slapplebags/Tracksoar_Hardware/README.md

View this project on [CADLAB.io](https://cadlab.io/project/1187). 

# Tracksoar_Hardware
