slapplebags/Tracksoar_Hardware/test boards/Tracksoar v2 .pdf

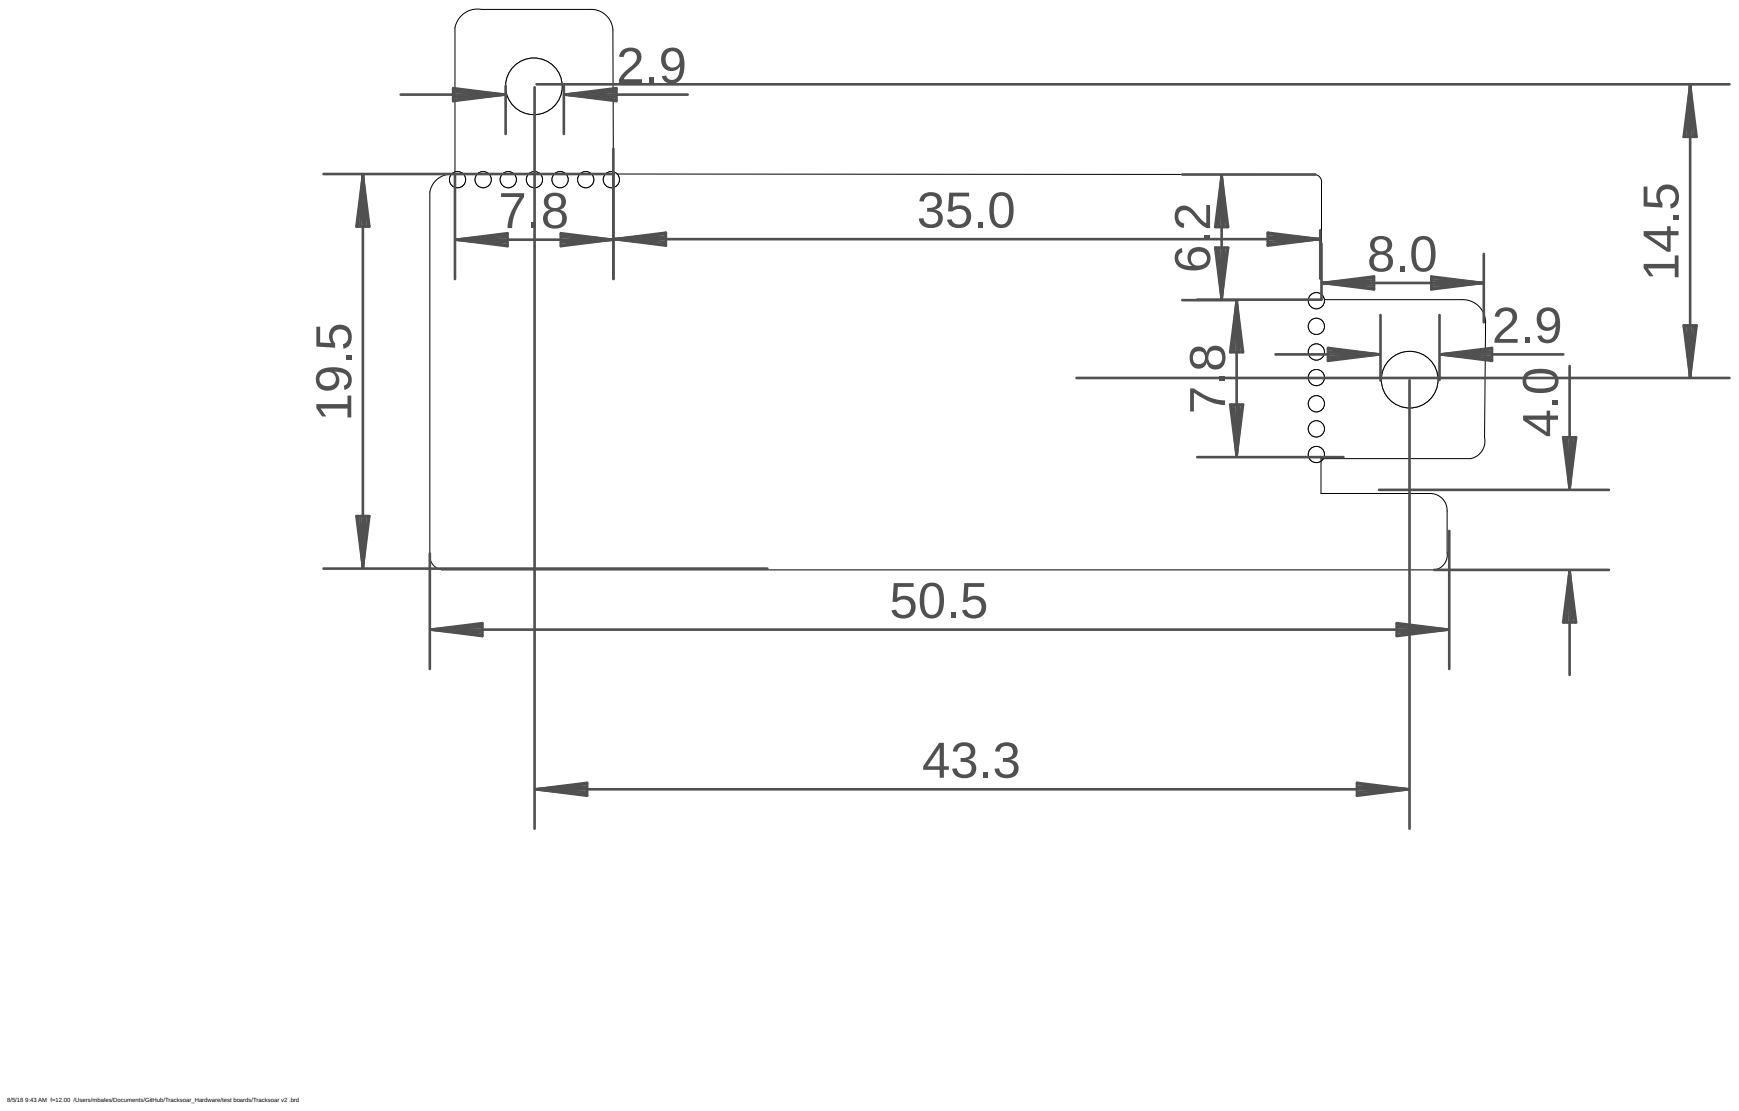
[picture p1: page 1]

8/5/18 9:43 AM f=12.00 /Users/mbales/Documents/GitHub/Tracksoar_Hardware/test boards/Tracksoar v2 .brd
