slapplebags/Tracksoar_Hardware/test boards/Tracksoar board bottom.pdf

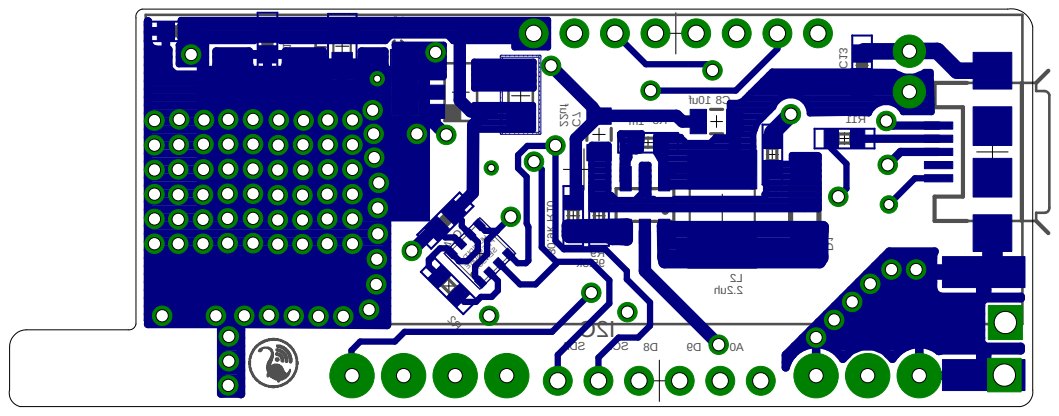
[picture p2: page 1]

C2I ADS L CS 8 D 9 D 0A 1 C f u1. D1 2L hu2. 2 m1 8 R 9 R k3. 59 R10 30.9k C7 22uff u01 8 C R2 11 R L1 C11 C13 C14 HUM DI TI Y PRESSURE SENSOR
