slapplebags/Tracksoar_Hardware/test boards/Tracksoar board power plane.pdf

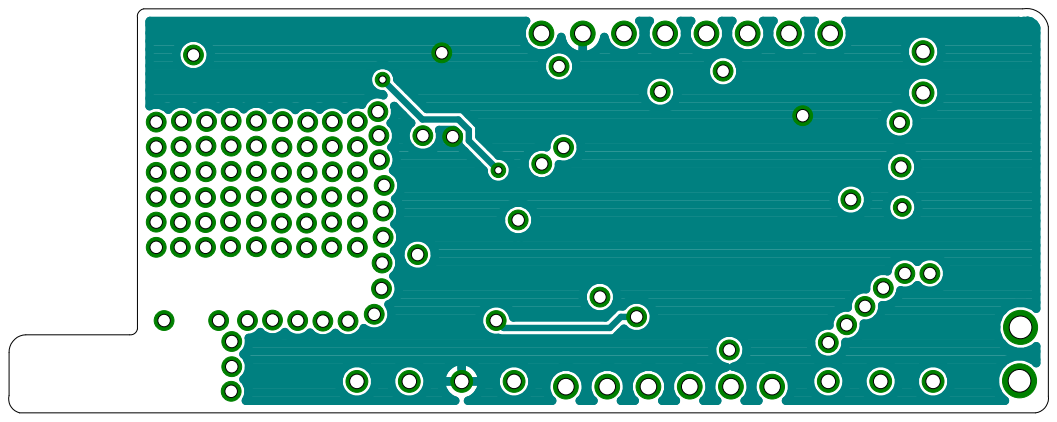
[picture p3: page 1]
