slapplebags/Tracksoar_Hardware/test boards/Tracksoar gndplane.pdf

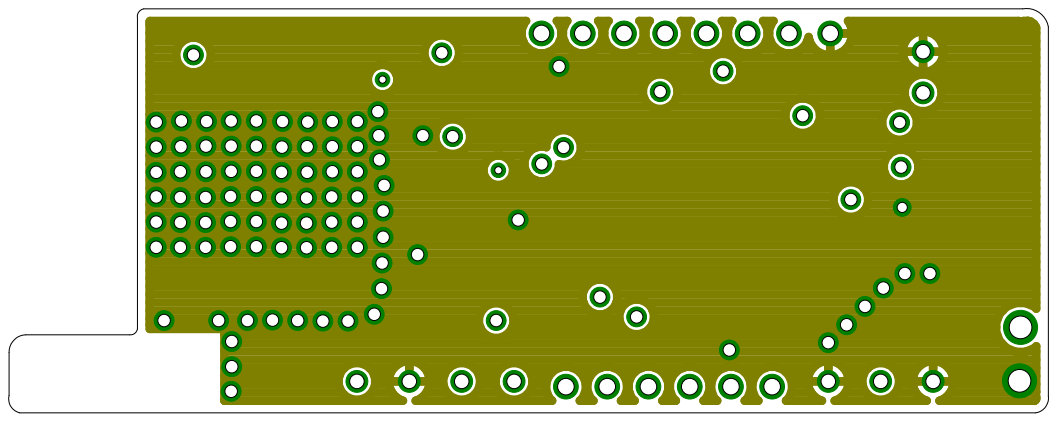
[picture p4: page 1]
