slapplebags/Tracksoar_Hardware/test boards/Tracksoar top board.pdf

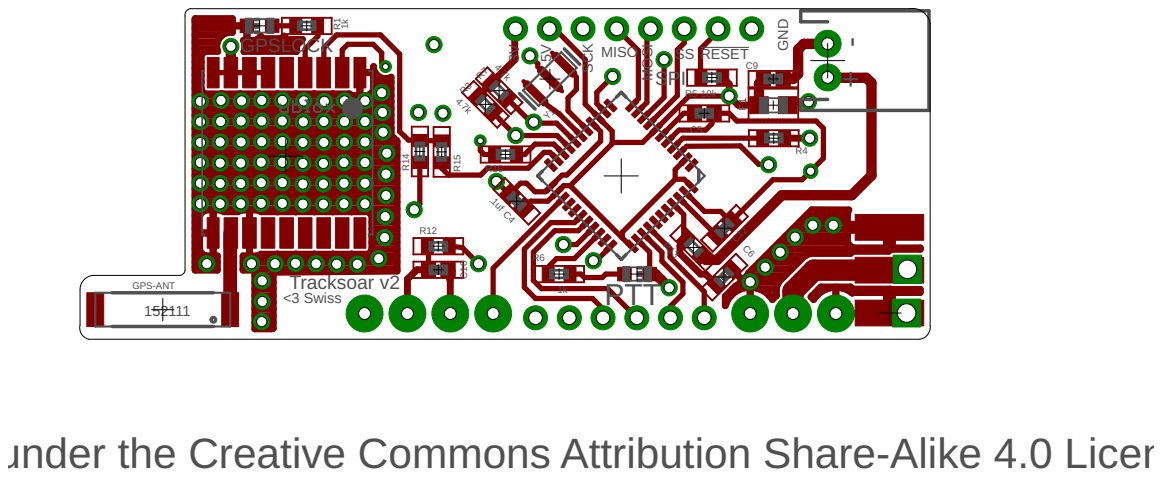
[picture p5: page 1]

Released under the Creative Commons Attribution Share-Alike 4.0 Licen
