slapplebags/Tracksoar_Hardware/test boards/Tracksoar v2 schematic.pdf

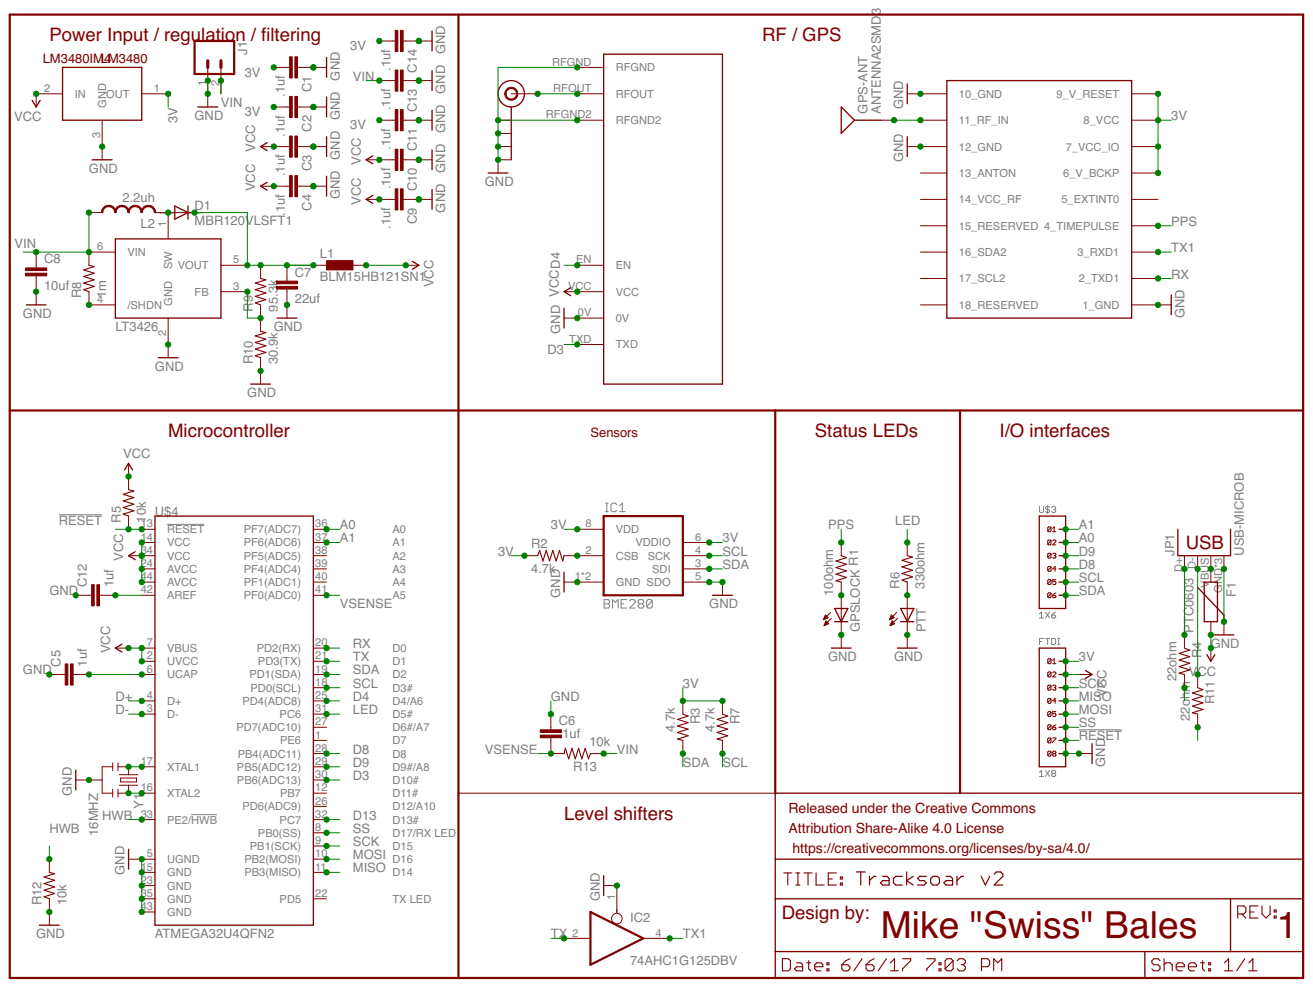
[picture p6: page 1]

Released under the Creative Commons Attribution Share-Alike 4.0 License

https://creativecommons.org/licenses/by-sa/4.0/
