slapplebags/Tracksoar_Hardware/test boards/Tracksoar v2 sd shield.brd

## EAGLE design test boards/Tracksoar v2 sd shield.brd (2019-05-08)

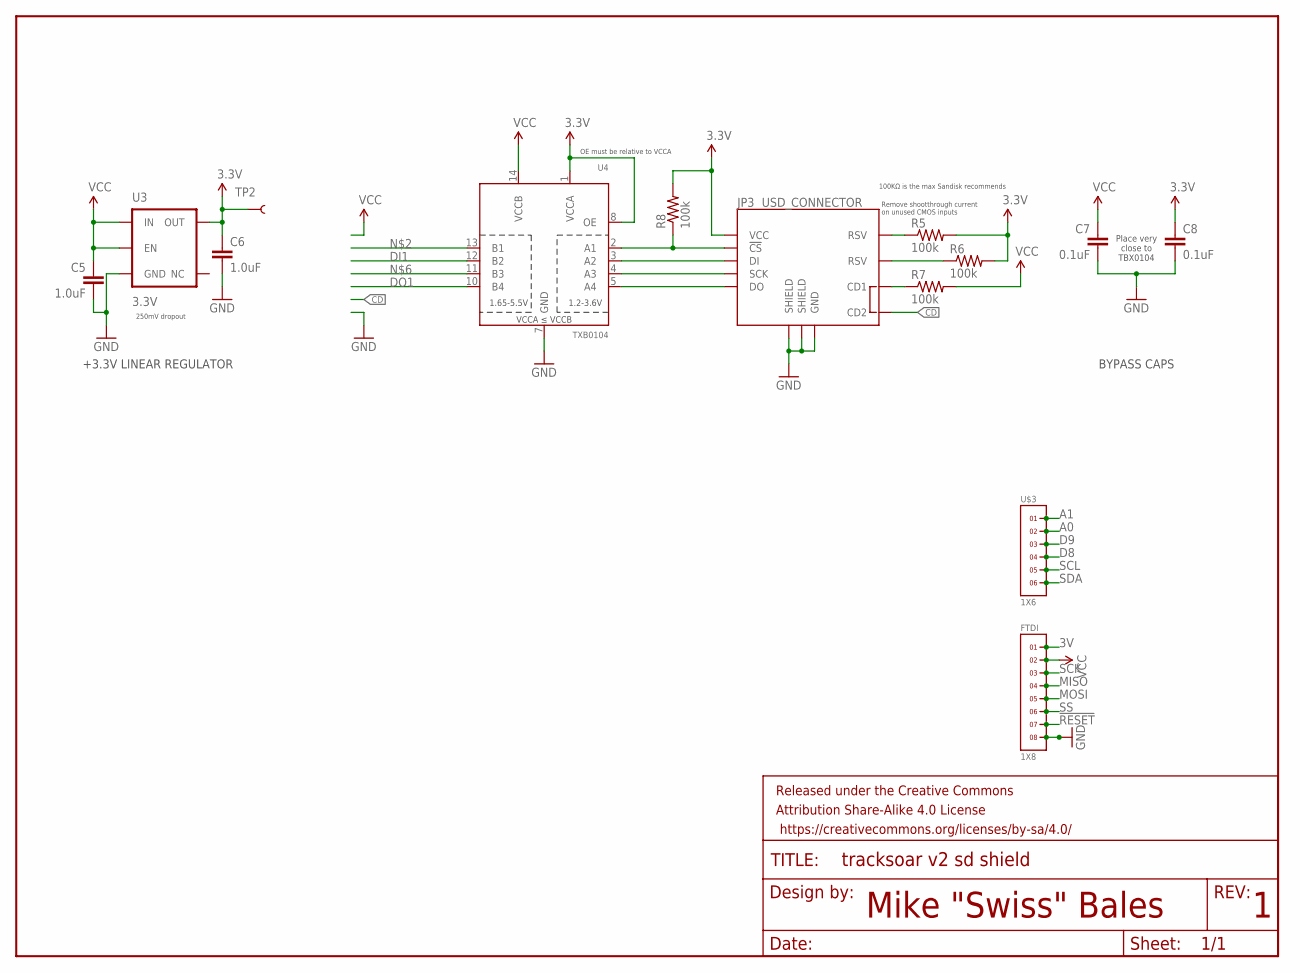
[picture p7: schematic Tracksoar v2 sd shield.sch]

Parts:
C5, C6: 1.0uF; 0603-CAP
C7, C8: 0.1uF; 0603-CAP
FRAME1: FRAME-LETTER; CREATIVE_COMMONS
FTDI: 1X8
JP3: USD_CONNECTOR; MICRO-SD-SOCKET-PP
R5, R6, R7, R8: 100k; 0603-RES
TP2: TEST-POINT3; PAD.03X.03
U3: 3.3V; SOT23-5
U4: TXB0104; SO14
U$3: 1X6

Connections:
3V: FTDI.1
3V3: C6.1, C8.1, JP3.VCC, R5.2, R6.2, R8.2, TP2.P$1, U3.5 (OUT), U4.1 (VCCA), U4.8 (OE)
!CS_3V1: JP3.CS (!CS), R8.1, U4.2 (A1)
!RESET: FTDI.7
A0: U$3.2
A1: U$3.1
CD: JP3.CD2
CDSDSD1: JP3.CD1, R7.1
D8: U$3.4
D9: U$3.3
DI1: U4.12 (B2)
DI_3V1: JP3.DI, U4.3 (A2)
DO1: U4.10 (B4)
DO_3V1: JP3.DO, U4.5 (A4)
GND: C5.2, C6.2, C7.2, C8.2, FTDI.8, JP3.GND, JP3.GND1 (SHIELD), JP3.GND3 (SHIELD), U3.2 (GND), U4.7 (GND)
MISO: FTDI.4
MOSI: FTDI.5
RSV@3: JP3.RSV1 (RSV), R5.1
RSV@4: JP3.RSV2 (RSV), R6.1
SCK: FTDI.3
SCK_3V1: JP3.SCLK (SCK), U4.4 (A3)
SCL: U$3.5
SDA: U$3.6
SS: FTDI.6
VCC: FTDI.2
VDD_IO: C5.1, C7.1, R7.2, U3.1 (IN), U3.3 (EN), U4.14 (VCCB)

Notes on the sheet:
Mike "Swiss" Bales
Remove shootthrough current on unused CMOS inputs
Place very close to TBX0104
OE must be relative to VCCA
+3.3V LINEAR REGULATOR
BYPASS CAPS
100KΩ is the max Sandisk recommends
250mV dropout

Board: 4 copper layers, 15 parts (13 on the bottom side), 10 nets, no tracks yet.
