slapplebags/Tracksoar_Hardware/test boards/Tracksoar v2 .brd

## EAGLE design test boards/Tracksoar v2 .brd (2019-05-08)

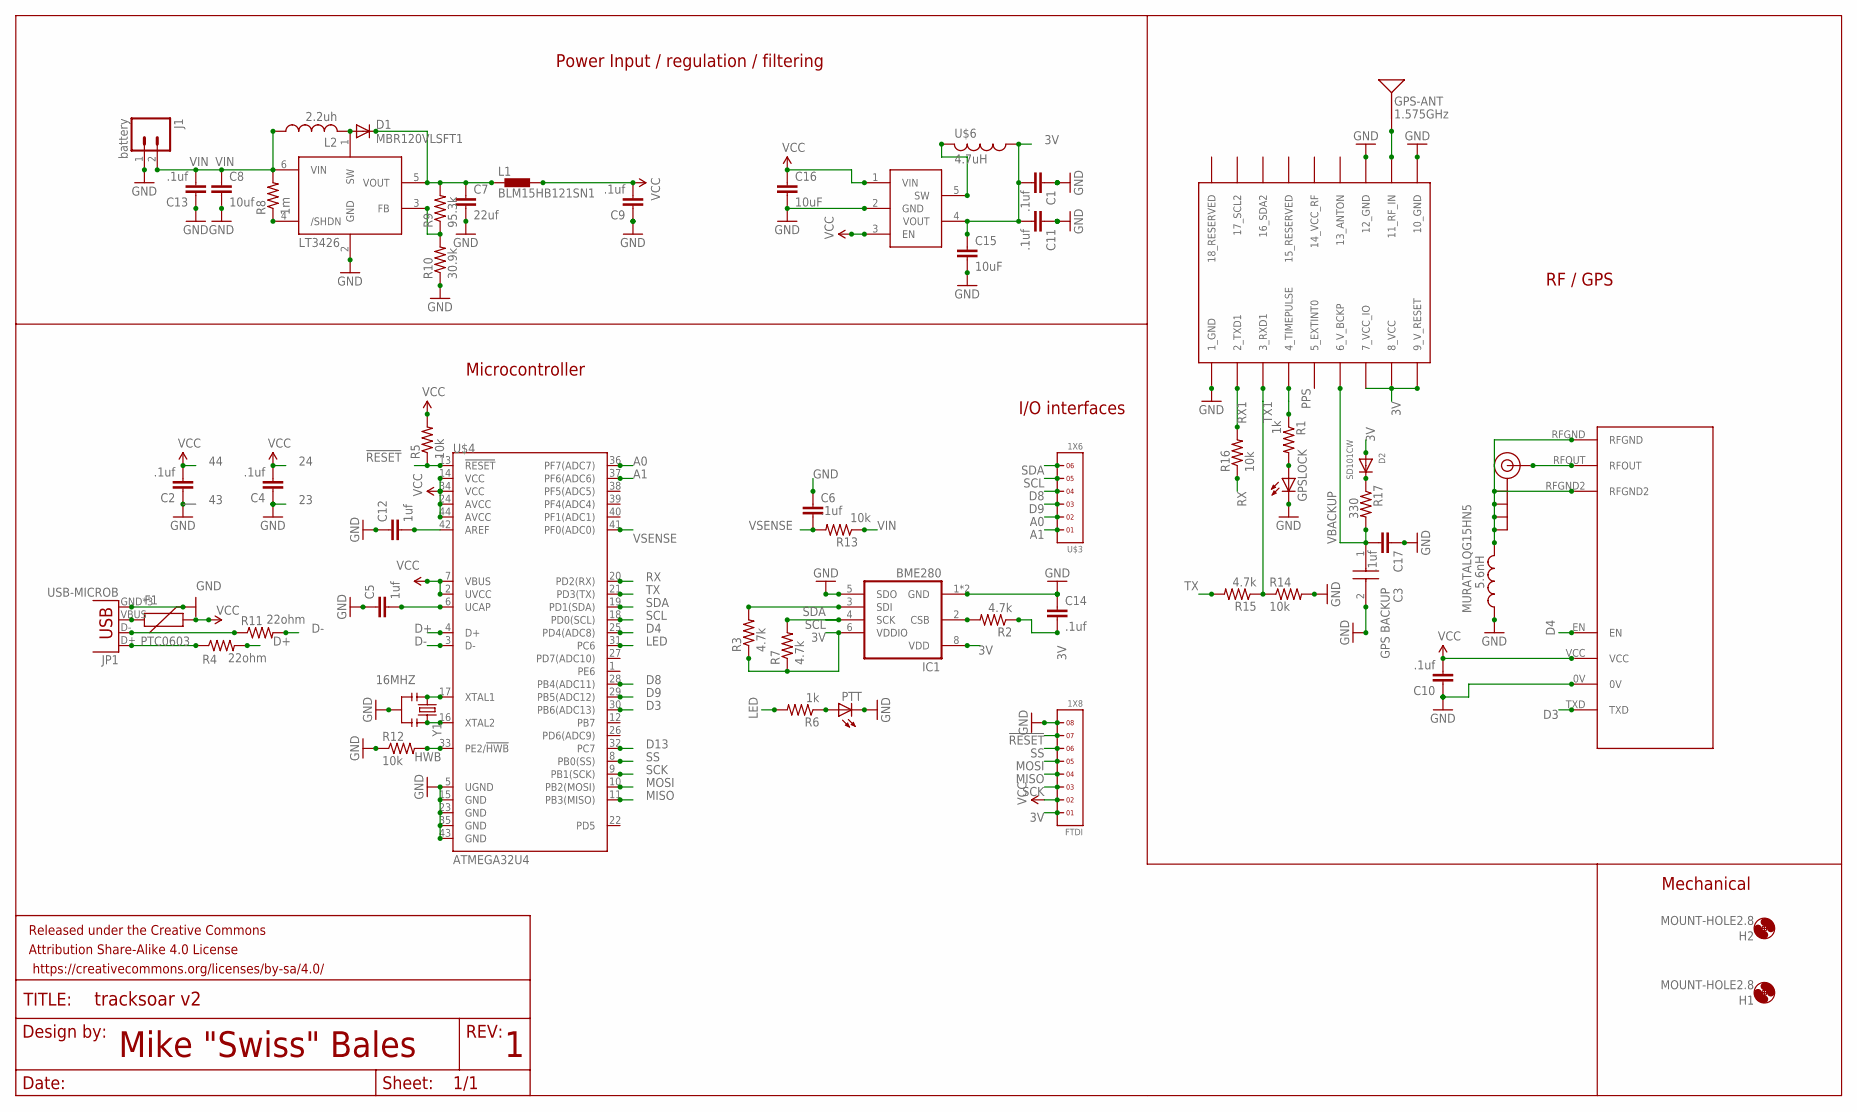
[picture p8: schematic Tracksoar v2 .sch]

Parts:
C1, C2, C4, C6, C9, C10, C11, C13, C14, C17: .1uf; 0402-CAP
C3: GPS BACKUP; DSK-3R3H204T614-H2L
C5, C12: 1uf; 0402-CAP
C7: 22uf; 0805
C8: 10uf; 0805
C15, C16: 10uF; 0603
D1: MBR120VLSFT1; SOD123
D2: SD101CW; SOD-123
F1: PTC0603; 0603
FRAME1: FRAME-LETTER; CREATIVE_COMMONS
FTDI: 1X8
GPS-ANT: 1.575GHz; ANT-GPS-2X7MM
GPSLOCK: LEDCHIP-LED0603; CHIP-LED0603
H1, H2: MOUNT-HOLE2.8; 2,8
IC1: BME280
J1: battery; JST-2-PTH
J$1: SMA_EDGE; SMA-EDGE
JP1: USB-MICROB
L1: BLM15HB121SN1; 0402
L2: 2.2uh; L1812
LT3426: LT3426; SOT23-6
MURATALQG15HN5: 5.6nH; RESC0402_N
PTT: LEDCHIP-LED0603; CHIP-LED0603
R1, R6: 1k; R0402
R2, R3, R7, R15: 4.7k; R0402
R4, R11: 22ohm; R0402
R5, R12, R13, R14, R16: 10k; R0402
R8: 1m; R0402
R9: 95.3k; R0402
R10: 30.9k; R0402
R17: 330; R0402
U$1: UBLOX_MAX
U$2: RADIOMETRIX-HX1
U$3: 1X6
U$4: ATMEGA32U4; QFN-44-NOPAD
U$5: PAM2305; DBV_R-PDSO-G5
U$6: 4.7uH; RESC0805_N
Y1: 16MHZ; RESONATOR-SMD

Connections:
3V: C1.2, C11.2, C14.2, C15.1, D2.A, FTDI.1, IC1.6 (VDDIO), IC1.8 (VDD), R2.1, R3.1, R7.1, U$1.7_VCC_IO, U$1.8_VCC, U$1.9_V_RESET, U$5.4 (VOUT), U$6.1
!RESET: FTDI.7, R5.1, U$4.13 (!RESET)
A0: U$3.2, U$4.36 (PF7(ADC7))
A1: U$3.1, U$4.37 (PF6(ADC6))
D3: U$2.TXD, U$4.30 (PB6(ADC13))
D4: U$2.EN, U$4.25 (PD4(ADC8))
D8: U$3.4, U$4.28 (PB4(ADC11))
D9: U$3.3, U$4.29 (PB5(ADC12))
D13: U$4.32 (PC7)
D+: R4.2, U$4.4 (D+)
D-: R11.2, U$4.3 (D-)
GND: C1.1, C2.1, C3.2 (-), C4.1, C5.1, C6.1, C7.2, C8.2, C9.1, C10.1, C11.1, C12.1, C13.1, C14.1, C15.2, C16.2, C17.1, FTDI.8, GPSLOCK.C, IC1.1 (GND), IC1.5 (SDO), IC1.7 (GND), J1.1, JP1.GND, JP1.MT1 (GND), JP1.MT2 (GND), LT3426.2 (GND), MURATALQG15HN5.1, PTT.C, R10.1, R12.1, R14.2, U$1.1_GND, U$1.10_GND, U$1.12_GND, U$2.0V, U$4.5 (UGND), U$4.15 (GND), U$4.23 (GND), U$4.35 (GND), U$4.43 (GND), U$5.2 (GND), Y1.2
HWB: R12.2, U$4.33 (PE2/!HWB)
LED: R6.2, U$4.31 (PC6)
MISO: FTDI.4, U$4.11 (PB3(MISO))
MOSI: FTDI.5, U$4.10 (PB2(MOSI))
unnamed: J$1.SIG (SIGNAL), U$2.RFOUT
unnamed: IC1.2 (CSB), R2.2
unnamed: GPSLOCK.A, R1.2
unnamed: GPS-ANT.1, U$1.11_RF_IN
unnamed: JP1.D-, R11.1
unnamed: JP1.D+, R4.1
unnamed: D1.A, L2.2, LT3426.1 (SW)
unnamed: LT3426.4 (/SHDN), R8.1
unnamed: LT3426.3 (FB), R9.1, R10.2
unnamed: F1.1, JP1.VBUS
unnamed: C12.2, U$4.42 (AREF)
unnamed: C7.1, D1.C, L1.1, LT3426.5 (VOUT), R9.2
unnamed: C5.2, U$4.6 (UCAP)
unnamed: U$5.5 (SW), U$6.2
unnamed: D2.C, R17.1
unnamed: PTT.A, R6.1
PPS: R1.1, U$1.4_TIMEPULSE
RFGND: J$1.GND@0 (GND), J$1.GND@1 (GND), J$1.GND@2 (GND), J$1.GND@3 (GND), MURATALQG15HN5.2, U$2.RFGND, U$2.RFGND2
RX: R16.1, U$4.20 (PD2(RX))
RX1: R16.2, U$1.2_TXD1
SCK: FTDI.3, U$4.9 (PB1(SCK))
SCL: IC1.4 (SCK), R7.2, U$3.5, U$4.18 (PD0(SCL))
SDA: IC1.3 (SDI), R3.2, U$3.6, U$4.19 (PD1(SDA))
SS: FTDI.6, U$4.8 (PB0(SS))
TX: R15.2, U$4.21 (PD3(TX))
TX1: R14.1, R15.1, U$1.3_RXD1
VBACKUP: C3.1 (+), C17.2, R17.2, U$1.6_V_BCKP
VCC: C2.2, C4.2, C9.2, C10.2, C16.1, F1.2, FTDI.2, L1.2, R5.2, U$2.VCC, U$4.2 (UVCC), U$4.7 (VBUS), U$4.14 (VCC), U$4.24 (AVCC), U$4.34 (VCC), U$4.44 (AVCC), U$5.1 (VIN), U$5.3 (EN)
VIN: C8.1, C13.2, J1.2, L2.1, LT3426.6 (VIN), R8.2, R13.1
VSENSE: C6.2, R13.2, U$4.41 (PF0(ADC0))
XTAL1: U$4.17 (XTAL1), Y1.1
XTAL2: U$4.16 (XTAL2), Y1.3

Notes on the sheet:
Mike "Swiss" Bales
Power Input / regulation / filtering
RF / GPS
Microcontroller
I/O interfaces
Mechanical

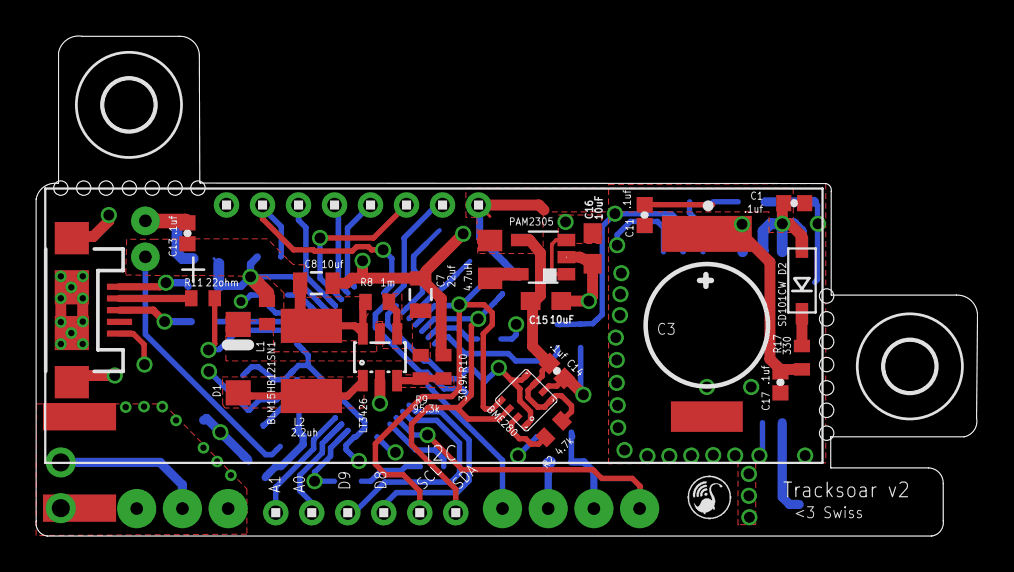
[picture p9: board Tracksoar v2 .brd from above]

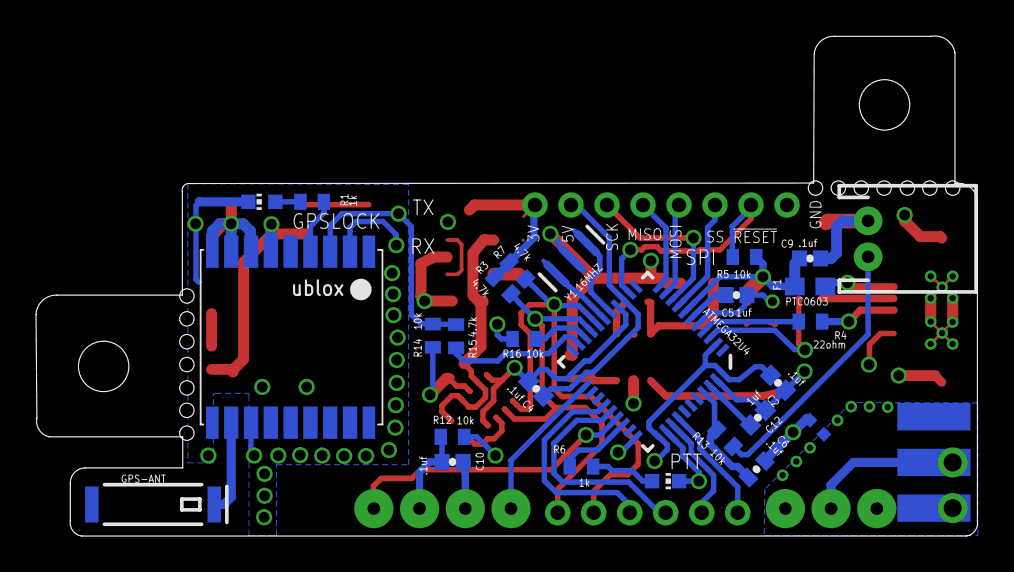
[picture p10: board Tracksoar v2 .brd from below]

Board: 4 copper layers, 52.3 x 27.8 mm, 59 parts (28 on the bottom side), 47 nets.
