slapplebags/Tracksoar_Hardware/test boards/Tracksoar v2 flash shield test.brd

## EAGLE design test boards/Tracksoar v2 flash shield test.brd (2018-07-14)

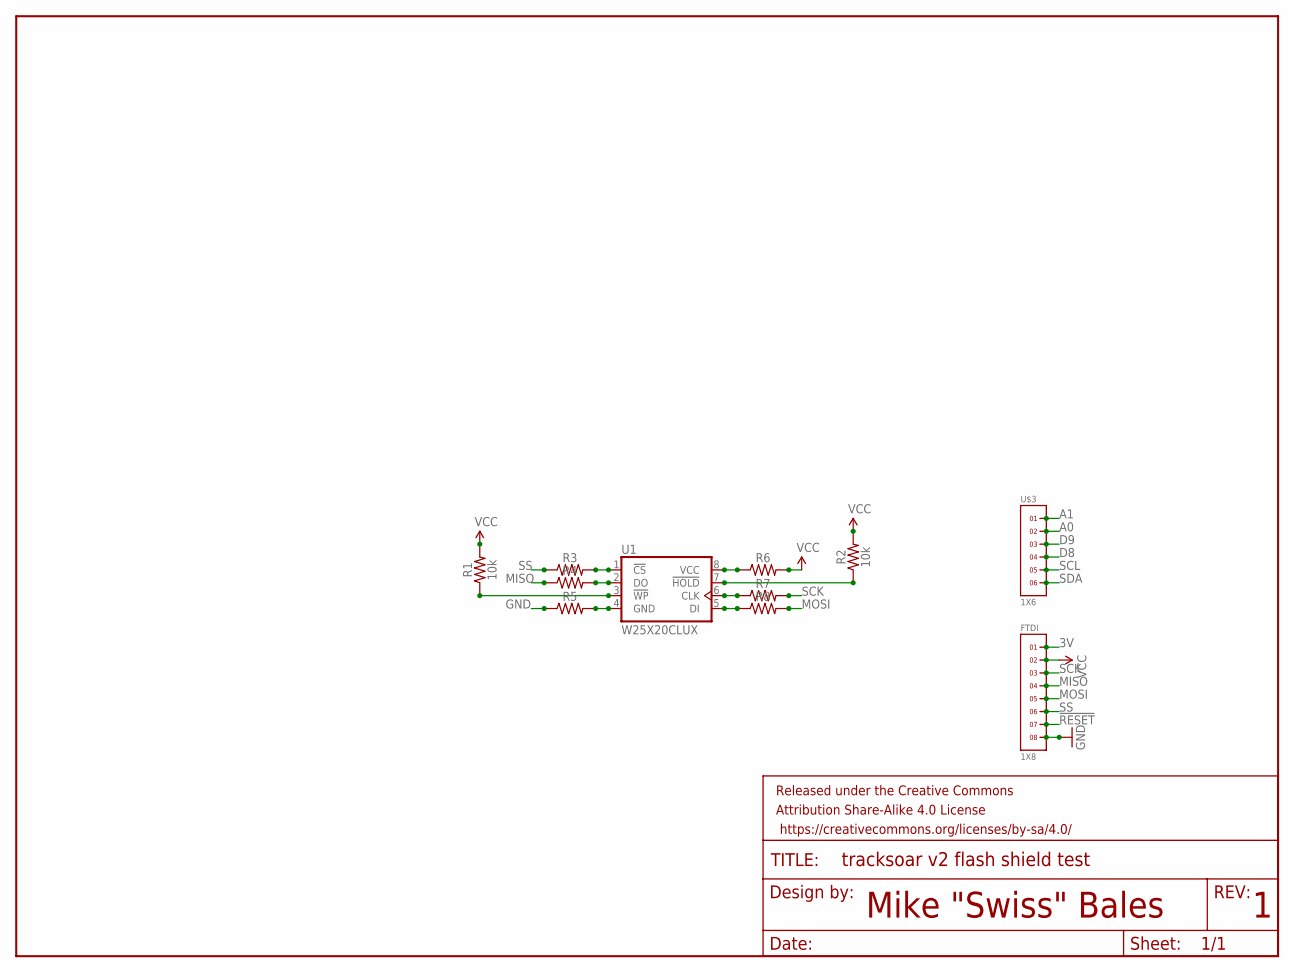
[picture p11: schematic Tracksoar v2 flash shield test.sch]

Parts:
FRAME1: FRAME-LETTER; CREATIVE_COMMONS
FTDI: 1X8
R1, R2: 10k; 0603
R3, R4, R5, R6, R7, R8: 0603
U1: W25X20CLUX; SON-8-50P-300W-200L-100H-40F-20EW-165EL
U$3: 1X6

Connections:
3V: FTDI.1
!RESET: FTDI.7
A0: U$3.2
A1: U$3.1
D8: U$3.4
D9: U$3.3
GND: FTDI.8, R5.1
MISO: FTDI.4, R4.1
MOSI: FTDI.5, R8.2
unnamed: R1.1, U1.3 (!WP!)
unnamed: R2.1, U1.7 (!HOLD!)
unnamed: R3.2, U1.1 (!CS!)
unnamed: R4.2, U1.2 (DO)
unnamed: R5.2, U1.4 (GND)
unnamed: R6.1, U1.8 (VCC)
unnamed: R7.1, U1.6 (CLK)
unnamed: R8.1, U1.5 (DI)
SCK: FTDI.3, R7.2
SCL: U$3.5
SDA: U$3.6
SS: FTDI.6, R3.1
VCC: FTDI.2, R1.2, R2.2, R6.2

Notes on the sheet:
Mike "Swiss" Bales

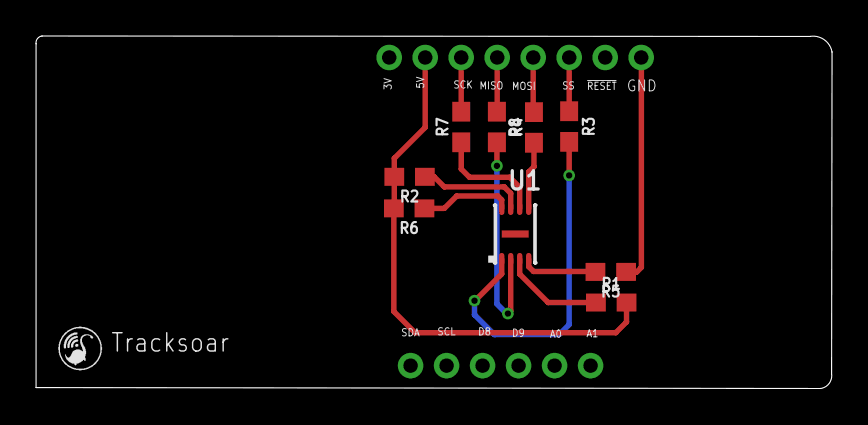
[picture p12: board Tracksoar v2 flash shield test.brd from above]

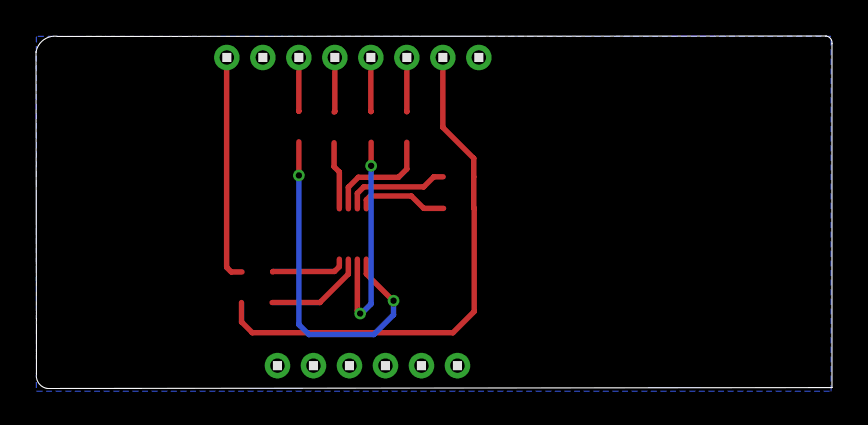
[picture p13: board Tracksoar v2 flash shield test.brd from below]

Board: 4 copper layers, 44.2 x 19.6 mm, 12 parts (2 on the bottom side), 14 nets.
