slapplebags/Tracksoar_Hardware/test boards/cutdown.brd

## EAGLE design test boards/cutdown.brd (2018-07-14)

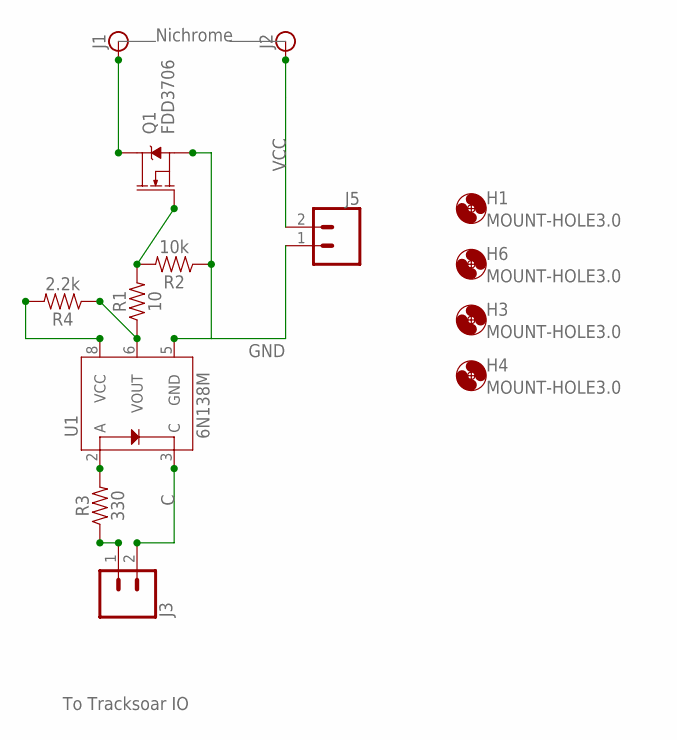
[picture p14: schematic cutdown.sch]

Parts:
H1, H3, H4, H6: MOUNT-HOLE3.0; 3,0
J1, J2: BANANA_CONN
J3, J5: CONN_02PTH3; 1X02_LONGPADS
Q1: FDD3706; DPAK
R1: 10; 0603
R2: 10k; 0603
R3: 330; 0603
R4: 2.2k; 0603
U1: 6N138M; 8-SMD

Connections:
A: J3.1, R3.1
C: J3.2, U1.3 (C)
GND: J5.1, Q1.3 (S), R2.1, U1.5 (GND)
unnamed: J1.P$1, Q1.4 (D)
unnamed: Q1.1 (G), R1.2, R2.2
unnamed: R1.1, R4.1, U1.6 (VOUT)
unnamed: R3.2, U1.2 (A)
unnamed: R4.2, U1.8 (VCC)
VCC: J2.P$1, J5.2

Notes on the sheet:
Nichrome
To Tracksoar IO

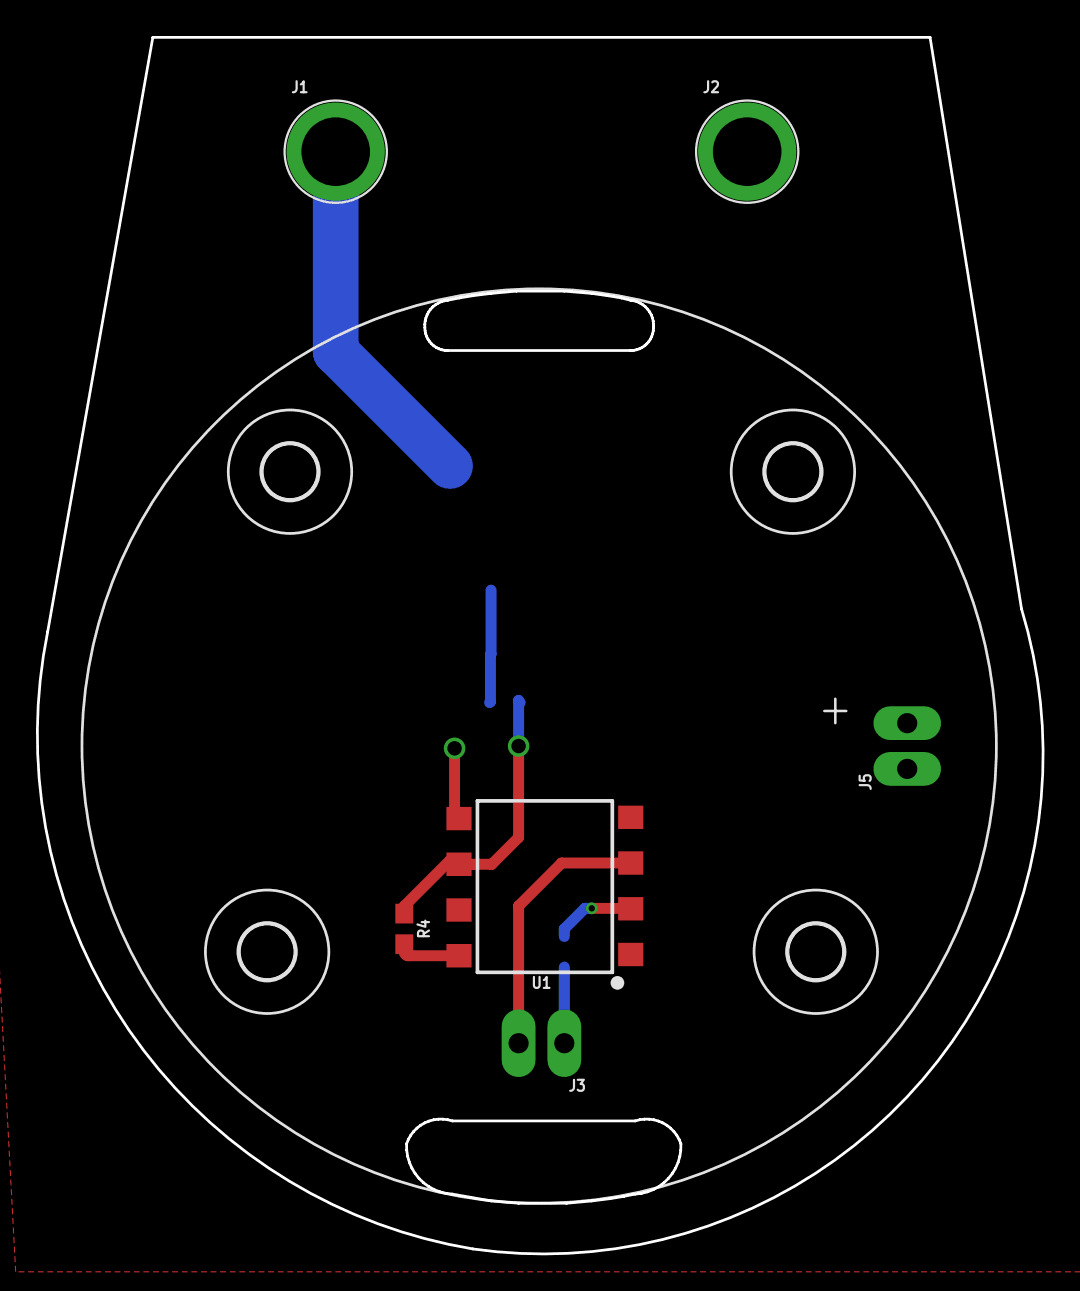
[picture p15: board cutdown.brd from above]

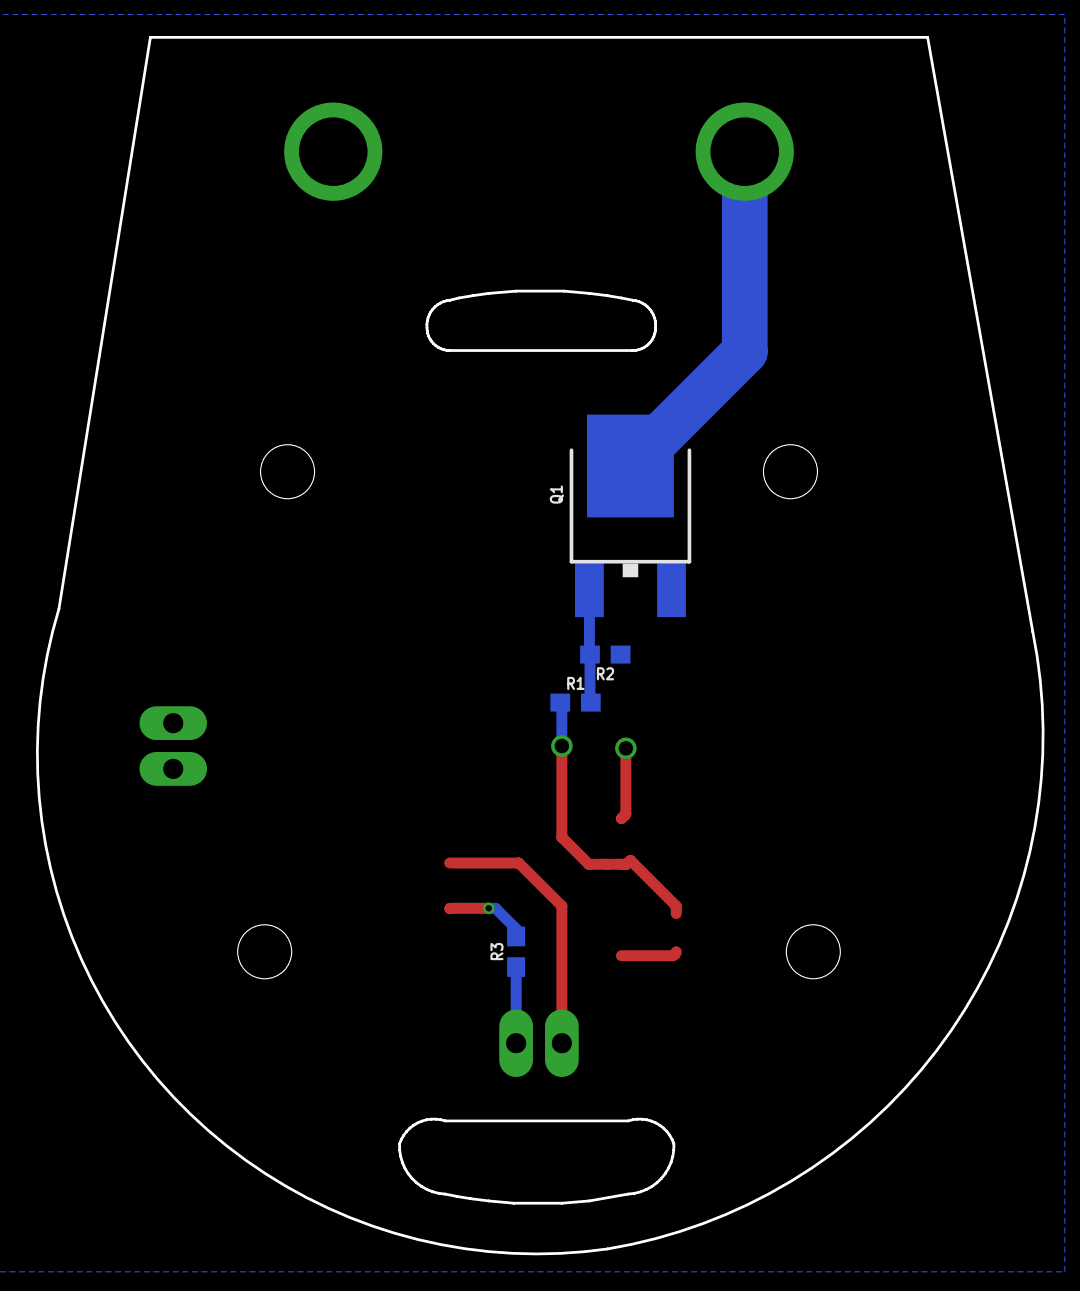
[picture p16: board cutdown.brd from below]

Board: 2 copper layers, 55.9 x 67.6 mm, 14 parts (4 on the bottom side), 9 nets.
