slapplebags/Tracksoar_Hardware/test boards/Tracksoar v2 breakout.brd

## EAGLE design test boards/Tracksoar v2 breakout.brd (2018-05-06)

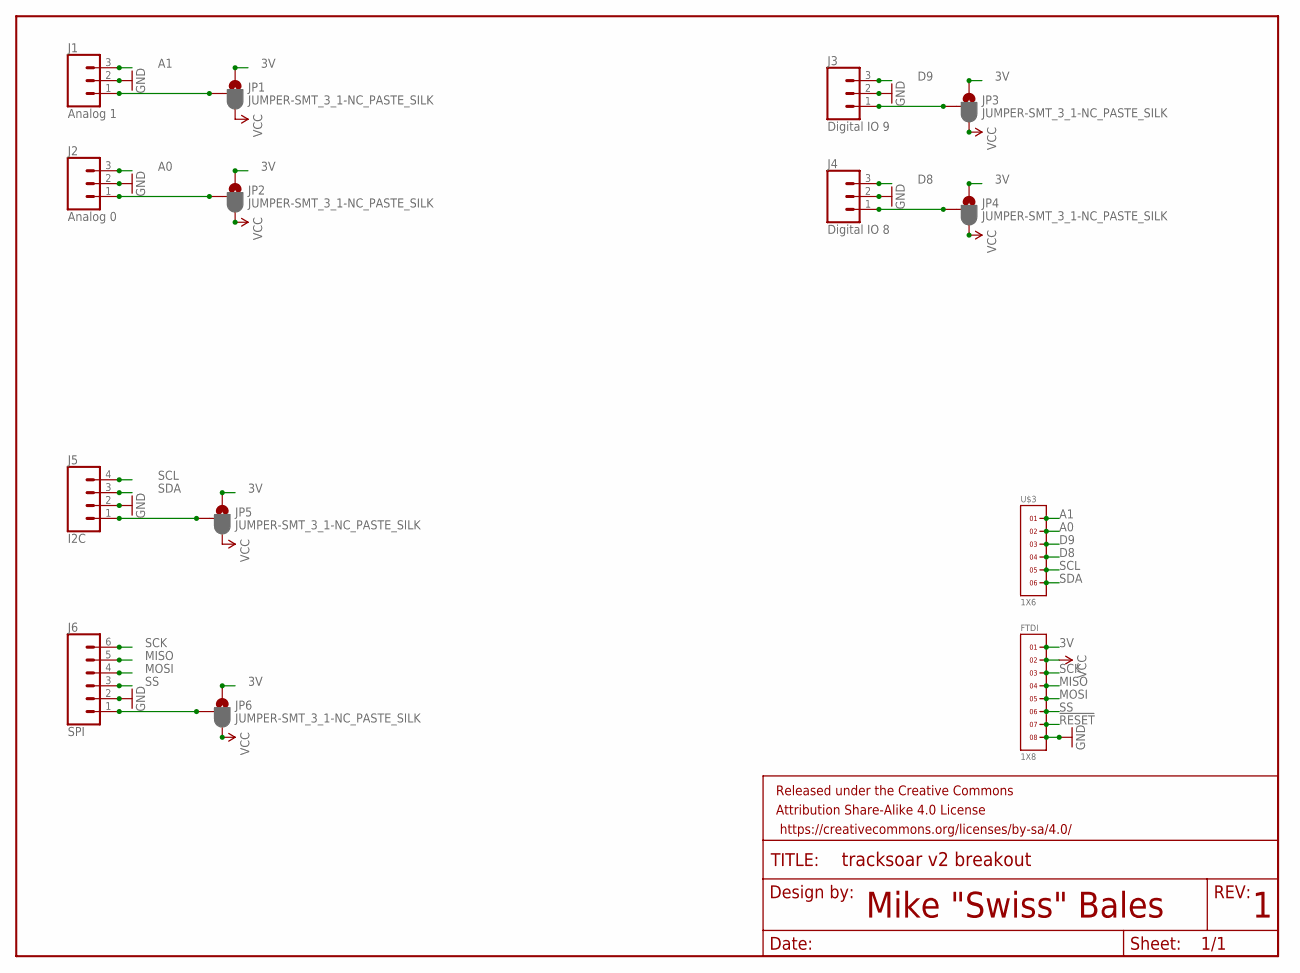
[picture p17: schematic Tracksoar v2 breakout.sch]

Parts:
FRAME1: FRAME-LETTER; CREATIVE_COMMONS
FTDI: 1X8
J1: Analog 1; 1X03_LONGPADS
J2: Analog 0; 1X03_LONGPADS
J3: Digital IO 9; 1X03_LONGPADS
J4: Digital IO 8; 1X03_LONGPADS
J5: I2C; 1X04_LONGPADS
J6: SPI; 1X06_LONGPADS
JP1, JP2, JP3, JP4, JP5, JP6: JUMPER-SMT_3_1-NC_PASTE_SILK; SMT-JUMPER_3_1-NC_PASTE_SILK
U$3: 1X6

Connections:
3V: FTDI.1, JP1.1, JP2.1, JP3.1, JP4.1, JP5.1, JP6.1
!RESET: FTDI.7
A0: J2.3, U$3.2
A1: J1.3, U$3.1
D8: J4.3, U$3.4
D9: J3.3, U$3.3
GND: FTDI.8, J1.2, J2.2, J3.2, J4.2, J5.2, J6.2
MISO: FTDI.4, J6.5
MOSI: FTDI.5, J6.4
unnamed: J1.1, JP1.2
unnamed: J2.1, JP2.2
unnamed: J3.1, JP3.2
unnamed: J4.1, JP4.2
unnamed: J5.1, JP5.2
unnamed: J6.1, JP6.2
SCK: FTDI.3, J6.6
SCL: J5.4, U$3.5
SDA: J5.3, U$3.6
SS: FTDI.6, J6.3
VCC: FTDI.2, JP1.3, JP2.3, JP3.3, JP4.3, JP5.3, JP6.3

Notes on the sheet:
Mike "Swiss" Bales

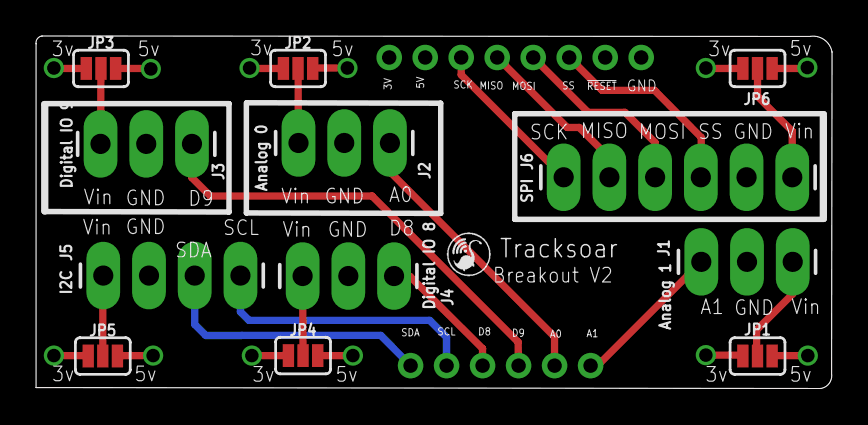
[picture p18: board Tracksoar v2 breakout.brd from above]

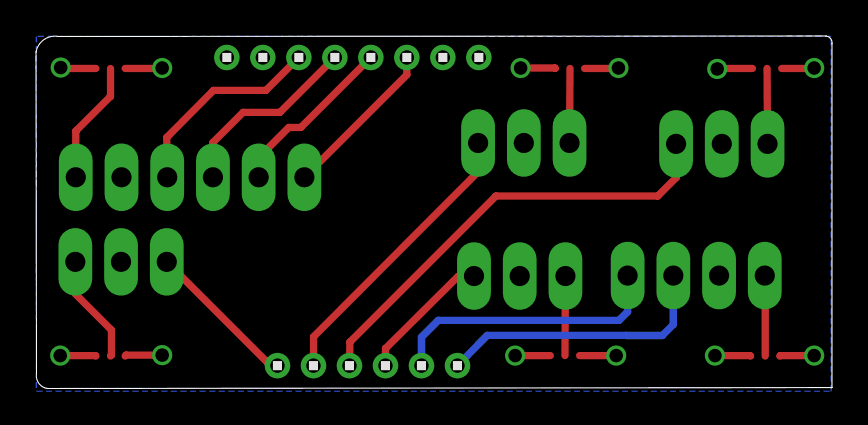
[picture p19: board Tracksoar v2 breakout.brd from below]

Board: 4 copper layers, 44.2 x 19.6 mm, 15 parts (2 on the bottom side), 19 nets.
