slapplebags/Tracksoar_Hardware/Tracksoar/Tracksoar.brd

## EAGLE design Tracksoar/Tracksoar.brd (2017-05-25)

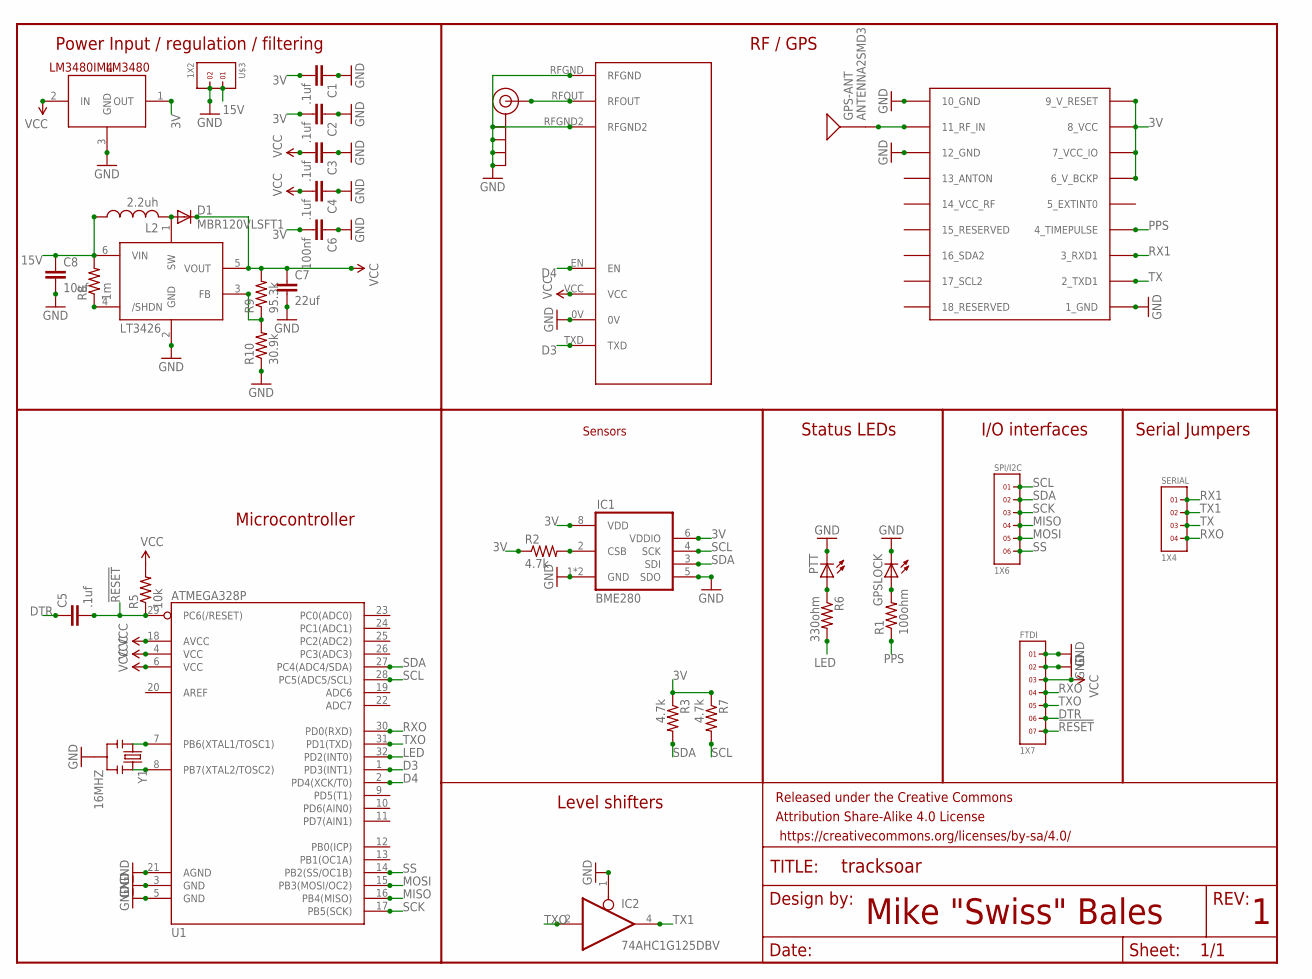
[picture p20: schematic Tracksoar.sch]

Parts:
C1, C2, C3, C4, C5: .1uf; 0805
C6: 100nf; 0805
C7: 22uf; 0805
C8: 10uf; 0805
D1: MBR120VLSFT1; SOD123
FRAME1: FRAME-LETTER; CREATIVE_COMMONS
FTDI: 1X7
GPS-ANT: ANTENNA2SMD3; ANTENNA-CHIP4
GPSLOCK: LEDCHIP-LED0805; CHIP-LED0805
IC1: BME280
IC2: 74AHC1G125DBV; SOT23-5
J$1: SMA_EDGE; SMA-EDGE
L2: 2.2uh; L1812
LM3480: LM3480IM4; SOT23-3
LT3426: LT3426; SOT23-6
PTT: LEDCHIP-LED0805; CHIP-LED0805
R1: 100ohm; 0805
R2, R3, R7: 4.7k; 0805
R5: 10k; 0805
R6: 330ohm; 0805
R8: 1m; 0805
R9: 95.3k; 0805
R10: 30.9k; 0805
SERIAL: 1X4
SPI/I2C: 1X6
U1: ATMEGA328P; MLF32
U$1: UBLOX_MAX
U$2: RADIOMETRIX-HX1
U$3: 1X2
Y1: 16MHZ; RESONATOR-SMD

Connections:
3V: C1.2, C2.2, C6.2, IC1.6 (VDDIO), IC1.8 (VDD), LM3480.1 (OUT), R2.1, R3.1, R7.1, U$1.6_V_BCKP, U$1.7_VCC_IO, U$1.8_VCC, U$1.9_V_RESET
15V: C8.1, L2.1, LT3426.6 (VIN), R8.2, U$3.1
!RESET: C5.2, FTDI.7, R5.1, U1.29 (PC6(/RESET))
D3: U1.1 (PD3(INT1)), U$2.TXD
D4: U1.2 (PD4(XCK/T0)), U$2.EN
DTR: C5.1, FTDI.6
GND: C1.1, C2.1, C3.1, C4.1, C6.1, C7.2, C8.2, FTDI.1, FTDI.2, GPSLOCK.C, IC1.1 (GND), IC1.5 (SDO), IC1.7 (GND), IC2.1 (OE), IC2.3 (GND), J$1.GND@0 (GND), J$1.GND@1 (GND), J$1.GND@2 (GND), J$1.GND@3 (GND), LM3480.3 (GND), LT3426.2 (GND), PTT.C, R10.1, U1.3 (GND), U1.5 (GND), U1.21 (AGND), U$1.1_GND, U$1.10_GND, U$1.12_GND, U$2.0V, U$2.RFGND, U$2.RFGND2, U$3.2, Y1.2
LED: R6.2, U1.32 (PD2(INT0))
MISO: SPI/I2C.4, U1.16 (PB4(MISO))
MOSI: SPI/I2C.5, U1.15 (PB3(MOSI/OC2))
unnamed: J$1.SIG (SIGNAL), U$2.RFOUT
unnamed: IC1.2 (CSB), R2.2
unnamed: GPSLOCK.A, R1.2
unnamed: GPS-ANT.SIG, U$1.11_RF_IN
unnamed: D1.A, L2.2, LT3426.1 (SW)
unnamed: LT3426.4 (/SHDN), R8.1
unnamed: LT3426.3 (FB), R9.1, R10.2
unnamed: U1.8 (PB7(XTAL2/TOSC2)), Y1.3
unnamed: U1.7 (PB6(XTAL1/TOSC1)), Y1.1
unnamed: PTT.A, R6.1
PPS: R1.1, U$1.4_TIMEPULSE
RX1: SERIAL.1, U$1.3_RXD1
RXO: FTDI.4, SERIAL.4, U1.30 (PD0(RXD))
SCK: SPI/I2C.3, U1.17 (PB5(SCK))
SCL: IC1.4 (SCK), R7.2, SPI/I2C.1, U1.28 (PC5(ADC5/SCL))
SDA: IC1.3 (SDI), R3.2, SPI/I2C.2, U1.27 (PC4(ADC4/SDA))
SS: SPI/I2C.6, U1.14 (PB2(SS/OC1B))
TX: SERIAL.3, U$1.2_TXD1
TX1: IC2.4 (O), SERIAL.2
TXO: FTDI.5, IC2.2 (I), U1.31 (PD1(TXD))
VCC: C3.2, C4.2, C7.1, D1.C, FTDI.3, IC2.5 (VCC), LM3480.2 (IN), LT3426.5 (VOUT), R5.2, R9.2, U1.4 (VCC), U1.6 (VCC), U1.18 (AVCC), U$2.VCC

Notes on the sheet:
Mike "Swiss" Bales
Power Input / regulation / filtering
RF / GPS
Microcontroller
Level shifters
Status LEDs
I/O interfaces
Serial Jumpers
Sensors

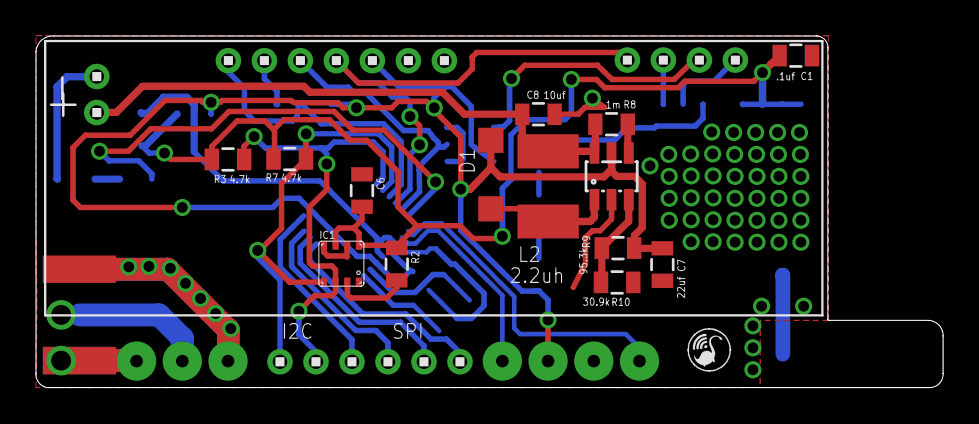
[picture p21: board Tracksoar.brd from above]

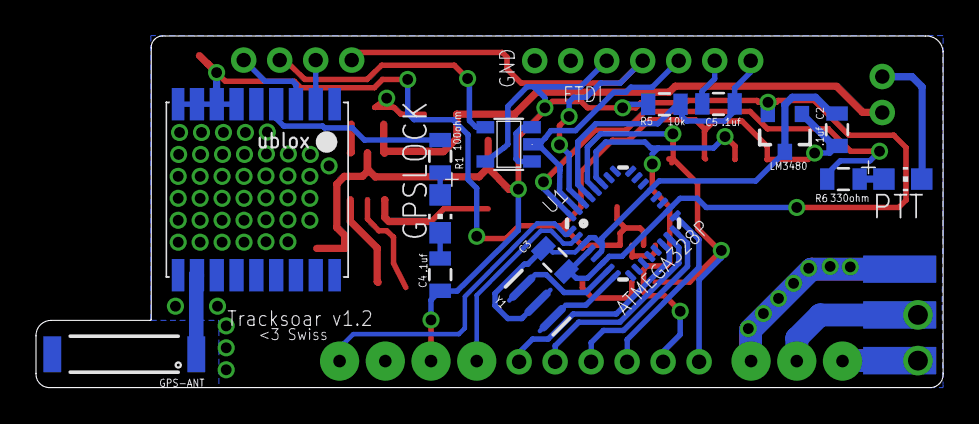
[picture p22: board Tracksoar.brd from below]

Board: 2 copper layers, 50.4 x 19.5 mm, 36 parts (16 on the bottom side), 31 nets.
