slapplebags/Tracksoar_Hardware/Tracksoar/Tracksoar imu shield.brd

## EAGLE design Tracksoar/Tracksoar imu shield.brd (2016-09-05)

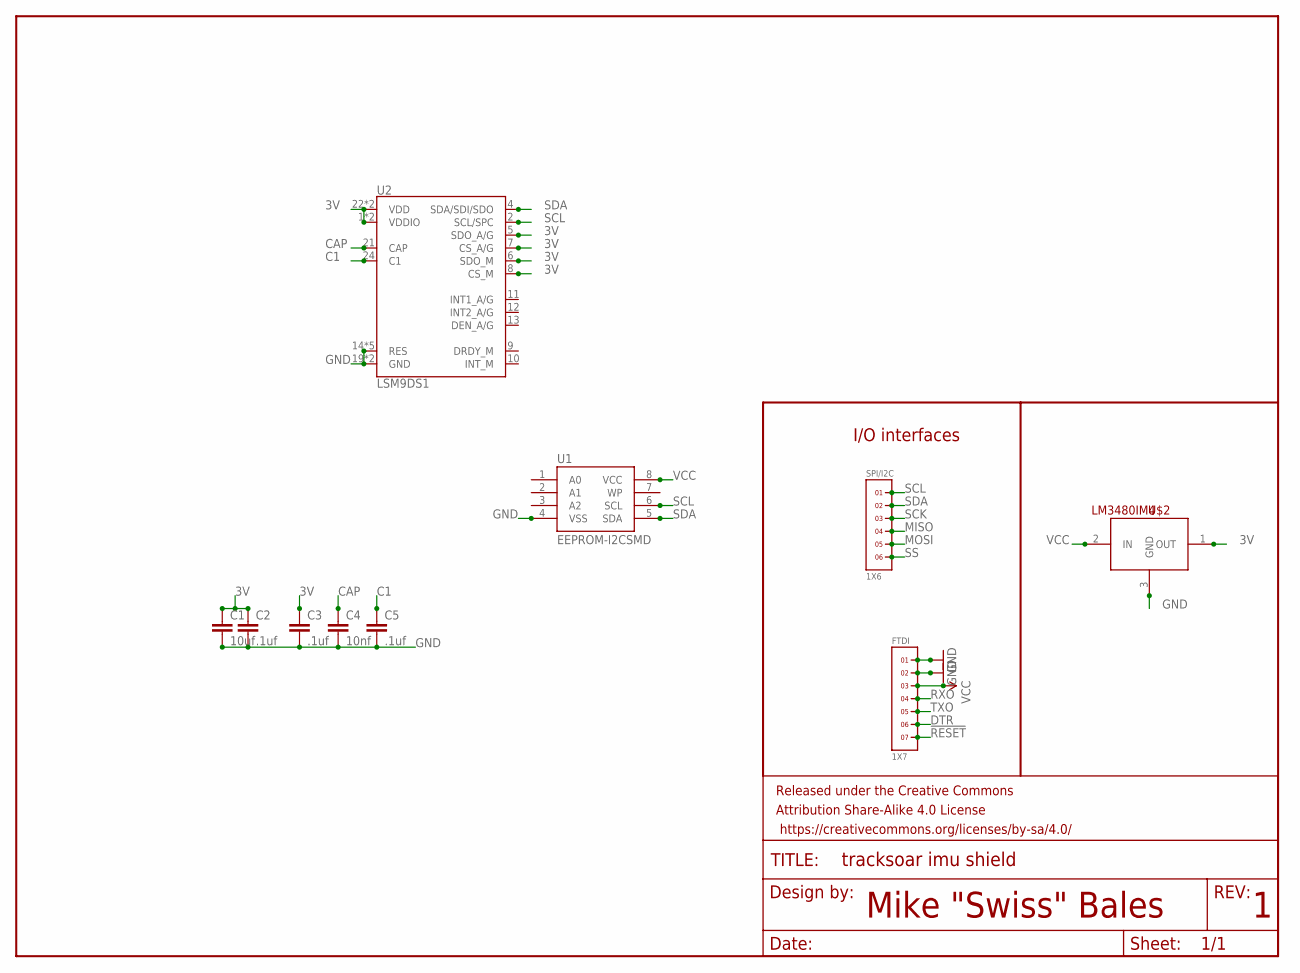
[picture p23: schematic Tracksoar imu shield.sch]

Parts:
C1: 10uf; 0805
C2, C3, C5: .1uf; 0805
C4: 10nf; 0805
FRAME1: FRAME-LETTER; CREATIVE_COMMONS
FTDI: 1X7
SPI/I2C: 1X6
U1: EEPROM-I2CSMD; SO08
U2: LSM9DS1; LGA24-8X4
U$2: LM3480IM4; SOT23-3

Connections:
3V: C1.1, C2.1, C3.1, U2.1 (VDDIO), U2.3 (VDDIO), U2.5 (SDO_A/G), U2.6 (SDO_M), U2.7 (CS_A/G), U2.8 (CS_M), U2.22 (VDD), U2.23 (VDD), U$2.1 (OUT)
!RESET: FTDI.7
C1: C5.1, U2.24 (C1)
CAP: C4.1, U2.21 (CAP)
DTR: FTDI.6
GND: C1.2, C2.2, C3.2, C4.2, C5.2, FTDI.1, FTDI.2, U1.4 (VSS), U2.14 (RES), U2.15 (RES), U2.16 (RES), U2.17 (RES), U2.18 (RES), U2.19 (GND), U2.20 (GND), U$2.3 (GND)
MISO: SPI/I2C.4
MOSI: SPI/I2C.5
RXO: FTDI.4
SCK: SPI/I2C.3
SCL: SPI/I2C.1, U1.6 (SCL), U2.2 (SCL/SPC)
SDA: SPI/I2C.2, U1.5 (SDA), U2.4 (SDA/SDI/SDO)
SS: SPI/I2C.6
TXO: FTDI.5
VCC: FTDI.3, U1.8 (VCC), U$2.2 (IN)

Notes on the sheet:
Mike "Swiss" Bales
I/O interfaces

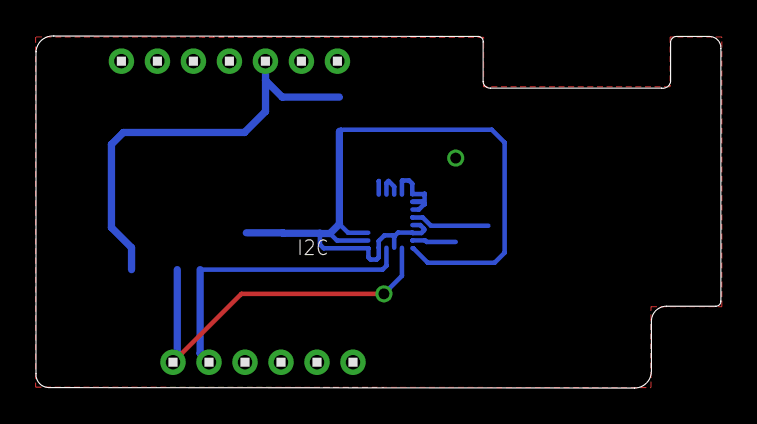
[picture p24: board Tracksoar imu shield.brd from above]

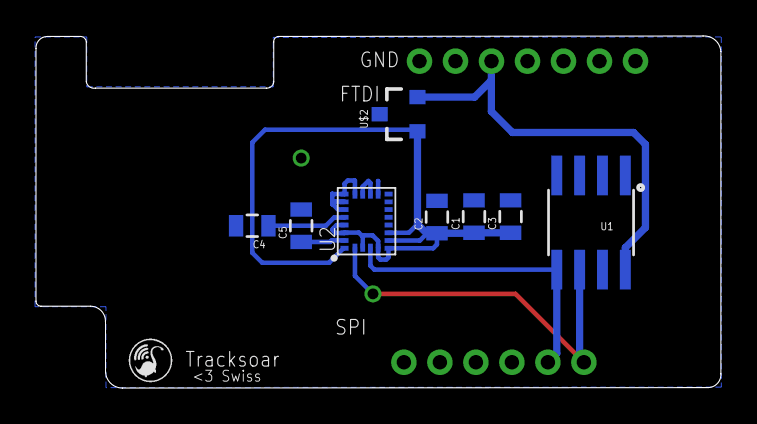
[picture p25: board Tracksoar imu shield.brd from below]

Board: 2 copper layers, 38.0 x 19.6 mm, 11 parts (8 on the bottom side), 7 nets.
