slapplebags/Tracksoar_Hardware/Tracksoar/Tracksoar programmer shield.brd

## EAGLE design Tracksoar/Tracksoar programmer shield.brd (2016-09-05)

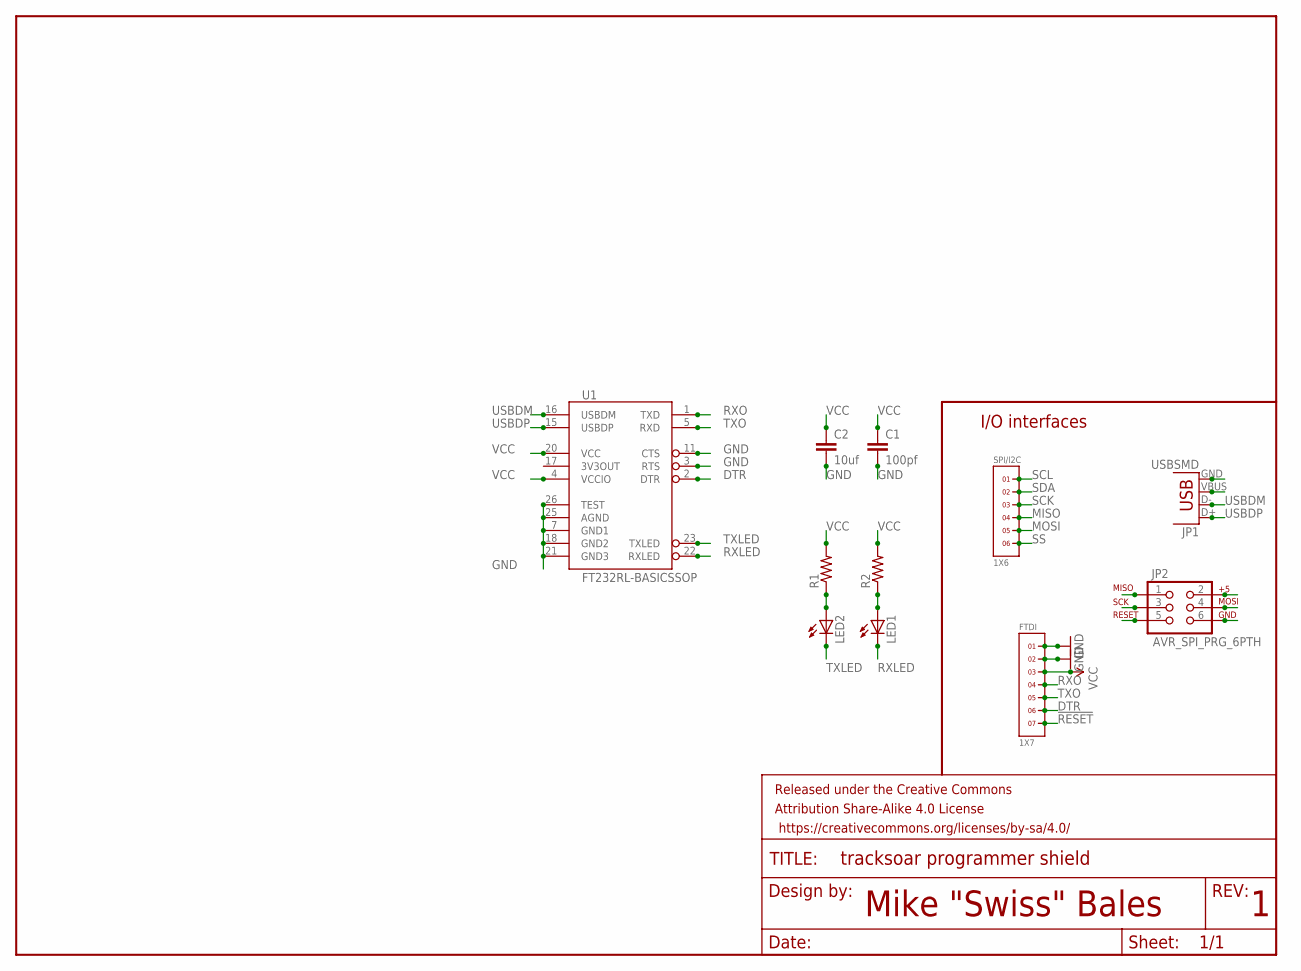
[picture p26: schematic Tracksoar programmer shield.sch]

Parts:
C1: 100pf; 0805
C2: 10uf; 0805
FRAME1: FRAME-LETTER; CREATIVE_COMMONS
FTDI: 1X7
JP1: USBSMD; USB-MINIB
JP2: AVR_SPI_PRG_6PTH; 2X3
LED1, LED2: LEDCHIP-LED0805; CHIP-LED0805
R1, R2: RESISTOR0805-RES; 0805
SPI/I2C: 1X6
U1: FT232RL-BASICSSOP; SSOP28DB

Connections:
!RESET: FTDI.7, JP2.5
DTR: FTDI.6, U1.2 (DTR)
GND: C1.2, C2.2, FTDI.1, FTDI.2, JP1.GND, JP2.6, U1.3 (RTS), U1.7 (GND1), U1.11 (CTS), U1.18 (GND2), U1.21 (GND3), U1.25 (AGND), U1.26 (TEST)
MISO: JP2.1, SPI/I2C.4
MOSI: JP2.4, SPI/I2C.5
unnamed: LED2.A, R1.1
unnamed: LED1.A, R2.1
RXLED: LED1.C, U1.22 (RXLED)
RXO: FTDI.4, U1.1 (TXD)
SCK: JP2.3, SPI/I2C.3
SCL: SPI/I2C.1
SDA: SPI/I2C.2
SS: SPI/I2C.6
TXLED: LED2.C, U1.23 (TXLED)
TXO: FTDI.5, U1.5 (RXD)
USBDM: JP1.D-, U1.16 (USBDM)
USBDP: JP1.D+, U1.15 (USBDP)
VCC: C1.1, C2.1, FTDI.3, JP1.VBUS, JP2.2, R1.2, R2.2, U1.4 (VCCIO), U1.20 (VCC)

Notes on the sheet:
Mike "Swiss" Bales
I/O interfaces

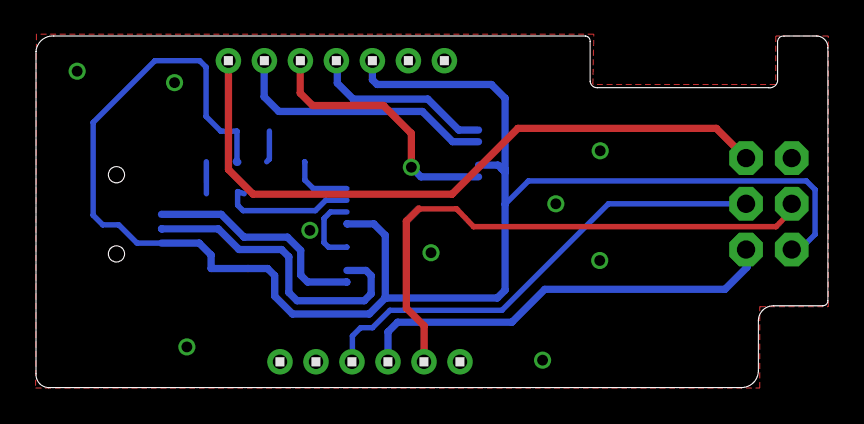
[picture p27: board Tracksoar programmer shield.brd from above]

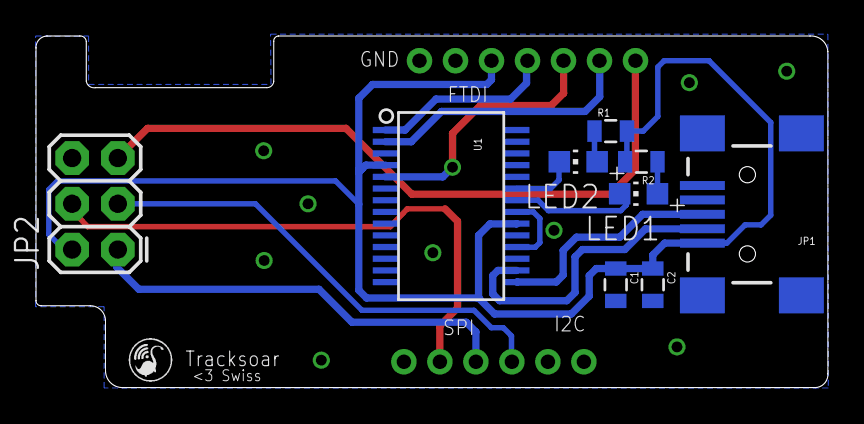
[picture p28: board Tracksoar programmer shield.brd from below]

Board: 2 copper layers, 44.0 x 19.5 mm, 12 parts (9 on the bottom side), 15 nets.
