slapplebags/Tracksoar_Hardware/Tracksoar/Tracksoar SD shield.brd

## EAGLE design Tracksoar/Tracksoar SD shield.brd (2016-09-05)

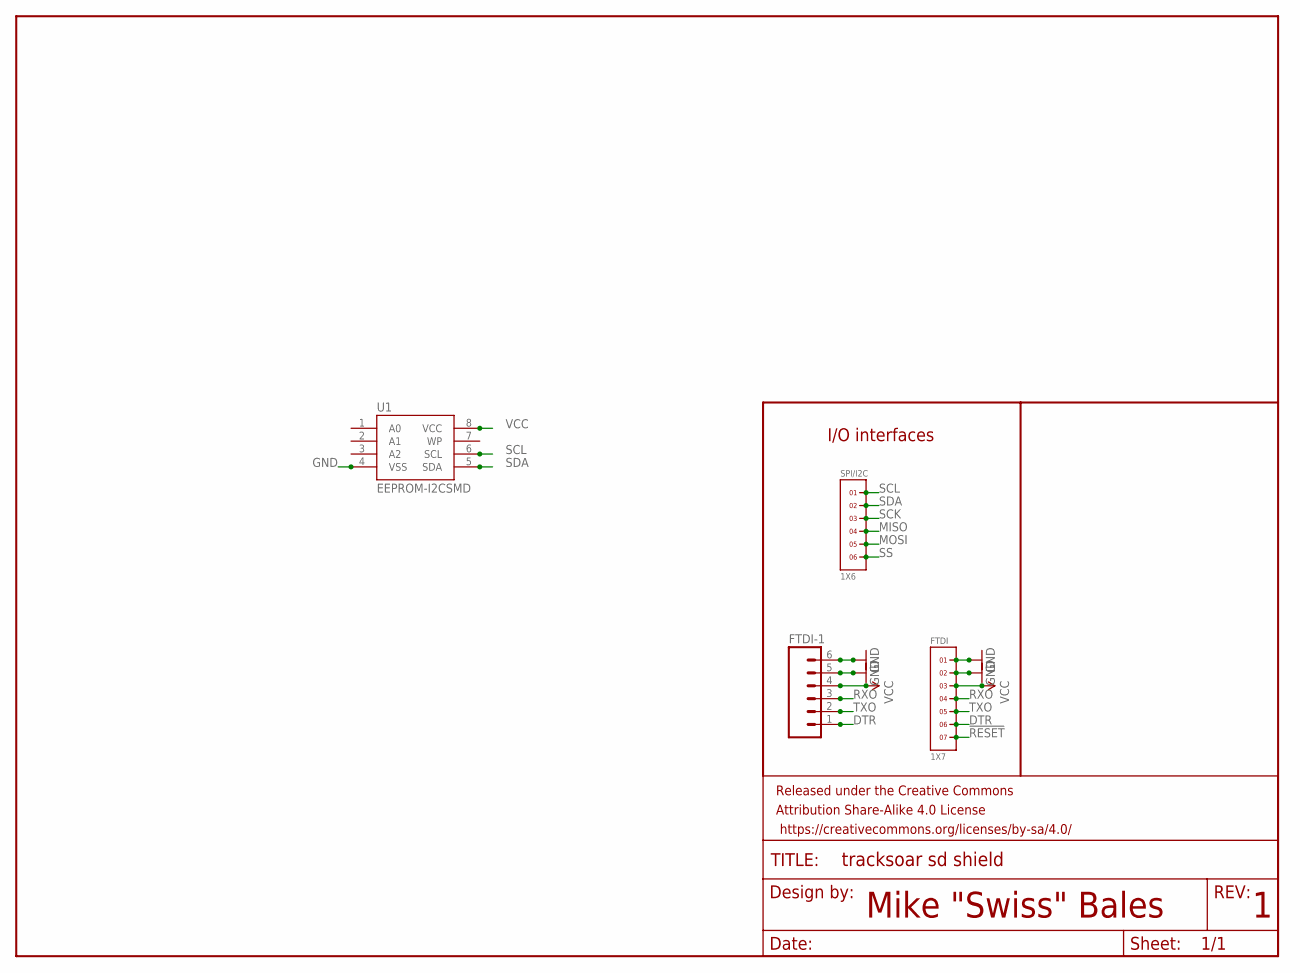
[picture p29: schematic Tracksoar SD shield.sch]

Parts:
FRAME1: FRAME-LETTER; CREATIVE_COMMONS
FTDI: 1X7
FTDI-1: M06LOCK_LONGPADS; 1X06_LOCK_LONGPADS
SPI/I2C: 1X6
U1: EEPROM-I2CSMD; SO08

Connections:
!RESET: FTDI.7
DTR: FTDI.6, FTDI-1.1
GND: FTDI.1, FTDI.2, FTDI-1.5, FTDI-1.6, U1.4 (VSS)
MISO: SPI/I2C.4
MOSI: SPI/I2C.5
RXO: FTDI.4, FTDI-1.3
SCK: SPI/I2C.3
SCL: SPI/I2C.1, U1.6 (SCL)
SDA: SPI/I2C.2, U1.5 (SDA)
SS: SPI/I2C.6
TXO: FTDI.5, FTDI-1.2
VCC: FTDI.3, FTDI-1.4, U1.8 (VCC)

Notes on the sheet:
Mike "Swiss" Bales
I/O interfaces

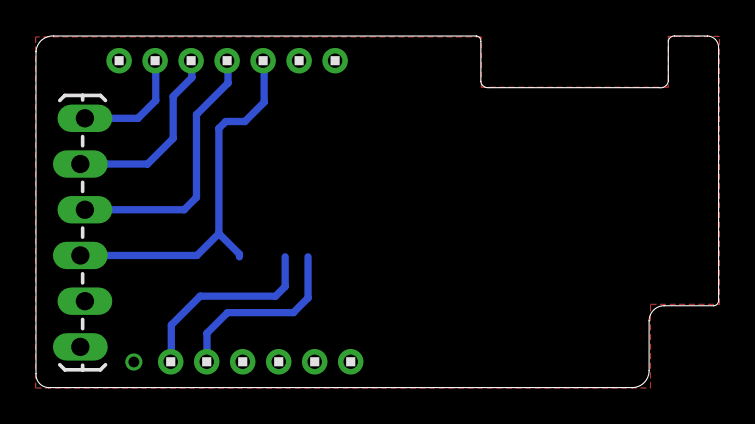
[picture p30: board Tracksoar SD shield.brd from above]

Board: 2 copper layers, 37.9 x 19.5 mm, 5 parts (1 on the bottom side), 7 nets.
