slapplebags/Tracksoar_Hardware/Tracksoar/Tracksoar Breakout Shield.brd

## EAGLE design Tracksoar/Tracksoar Breakout Shield.brd (2016-09-05)

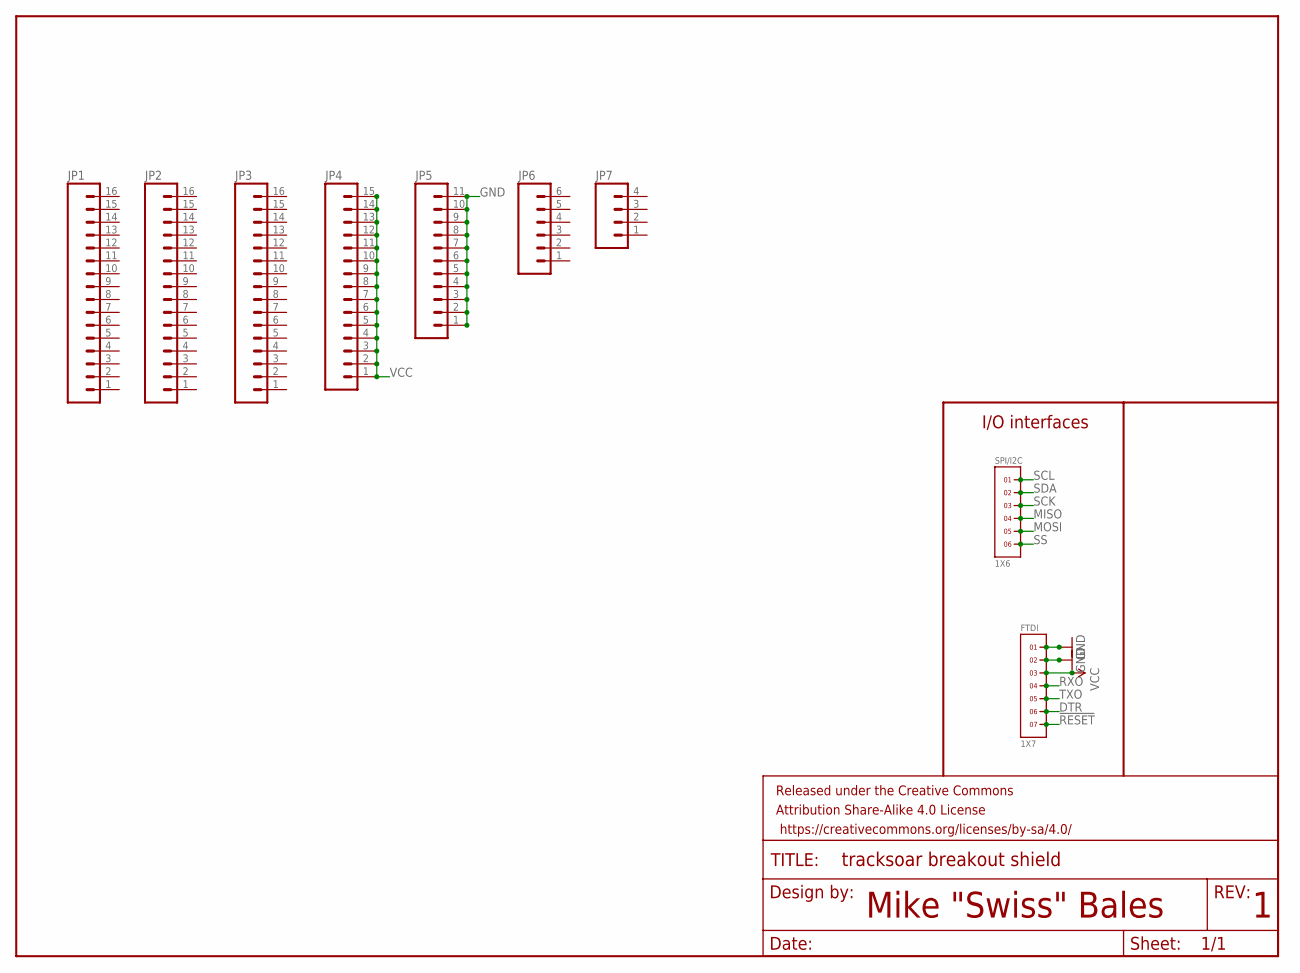
[picture p31: schematic Tracksoar Breakout Shield.sch]

Parts:
FRAME1: FRAME-LETTER; CREATIVE_COMMONS
FTDI: 1X7
JP1, JP2, JP3: M161X16_NO_SILK; 1X16_NO_SILK
JP4: M15; 1X15
JP5: M11PTH; 1X11
JP6: M06NO_SILK_FEMALE_PTH; 1X06_NO_SILK
JP7: M04NO_SILK_ALL_ROUND; 1X04_NO_SILK_ALL_ROUND
SPI/I2C: 1X6

Connections:
!RESET: FTDI.7
DTR: FTDI.6
GND: FTDI.1, FTDI.2, JP5.1, JP5.2, JP5.3, JP5.4, JP5.5, JP5.6, JP5.7, JP5.8, JP5.9, JP5.10, JP5.11
MISO: SPI/I2C.4
MOSI: SPI/I2C.5
RXO: FTDI.4
SCK: SPI/I2C.3
SCL: SPI/I2C.1
SDA: SPI/I2C.2
SS: SPI/I2C.6
TXO: FTDI.5
VCC: FTDI.3, JP4.1, JP4.2, JP4.3, JP4.4, JP4.5, JP4.6, JP4.7, JP4.8, JP4.9, JP4.10, JP4.11, JP4.12, JP4.13, JP4.14, JP4.15

Notes on the sheet:
Mike "Swiss" Bales
I/O interfaces

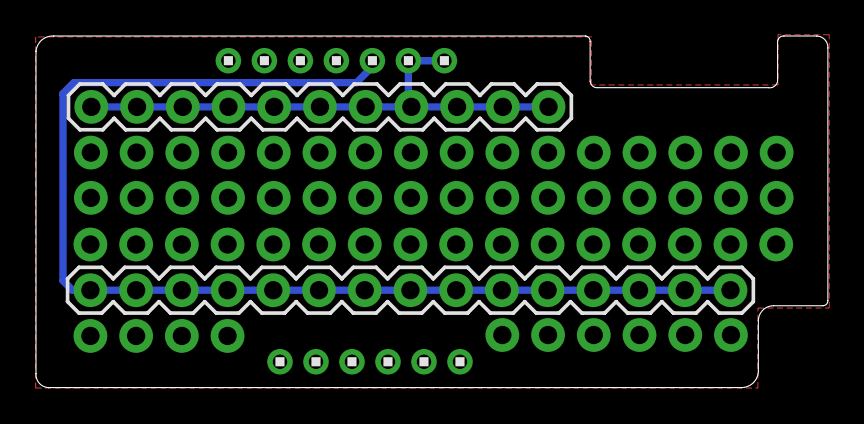
[picture p32: board Tracksoar Breakout Shield.brd from above]

Board: 2 copper layers, 44.0 x 19.5 mm, 10 parts (0 on the bottom side), 2 nets.
