slapplebags/Tracksoar_Hardware/(commit log)

2016-09-05 Added V1.1 board layout
    [Tracksoar.brd, Tracksoar.sch]
2016-09-05 Added V1.2 board
    [Tracksoar.brd, Tracksoar.sch]
2017-04-27 Added Tracksoar Test Board
    This is the Tracksoar V2 Rev4 test board.
    [Tracksoar v2.brd, Tracksoar v2.sch]
2017-04-29 tracksoar v2 rev 5
    converted to 4 layer board, covered via with solder mask, routed vcc
    and gnd on internal planes. Corrected AREF connection to ground via
    cap. Added analog pin connection to 15v to measure battery voltage.
    General routing cleanup.
    [Tracksoar v2 .brd, Tracksoar v2 .sch]
2017-04-29 Updated Via Tenting
    now vias are untented
    [Tracksoar v2 .brd]
2017-04-29 Soldermasked Vias and minor layout fixes
    solder masked vias to resolve soldering issues. Removed separated
    ground around RF output. Updated silkscreen to read v1.2 and prevent
    clipping of the L2 designator and value. Removed unnecessary ground
    vias. Fixed floating ground on BME280 sensor.
    [Tracksoar.brd]
2017-04-29 Updated Silkscreen
    Updated capacitor values and schematic symbols. Updated silkscreen to
    remove overlaps and standardized text size.
    [Tracksoar v2 .brd, Tracksoar v2 .sch]
2017-04-29 labelled headers
    added silkscreen labels to headers
    [Tracksoar v2 .brd]
2017-04-29 Corrected battery connector placement
    Moved the battery connector to the bottom side of the board to avoid
    conflicts with the USB connector
    [Tracksoar v2 .brd, Tracksoar v2 .sch]
2017-05-01 Tracksoar V1.3
    Created a new test board Tracksoar v1.3 to resolve potential issues
    with the boost converter interfering with GPS reception.
    [Tracksoar 1.3.brd, Tracksoar 1.3.sch, Tracksoar v2 .sch]
2017-05-01 Updated Silkscreen on Tracksoar V1.3
    Added individual pin designators, moved silkscreen items away from
    vias, standardized designator and value font size.
    [Tracksoar 1.3.brd]
2017-05-24 BME280 Decoupling Cap
    Added a 100nf decoupling cap next to the bme280
    [Tracksoar.brd, Tracksoar.sch]
2017-05-25 v2 BME280 decoupling cap
    added decoupling cap to bme280 of v2 board.
    [Tracksoar v2 .brd, Tracksoar v2 .sch, Tracksoar.brd]
2017-06-04 Added Pull down to HWB pin
    added a 10k pull down resistor to HWB to resolve issues flashing the
    boot loader
    [Tracksoar v2 .brd, Tracksoar v2 .sch]
2017-06-05 Swapped Serial1 RX and TX
    Fixed an issue sending / receiving serial between the atmega32u4 and
    ublox max m8q by swapping the rx and tx pins on the atmega32u4.
    [Tracksoar v2 .brd, Tracksoar v2 .sch]
2017-06-05 moved bme280 decoupling cap
    moved the bme280 decoupling cap a bit for aesthetic reasons.
    [Tracksoar v2 .brd]
2017-06-07 Silkscreen cleanup and additional analog pin
    removed as many silkscreen keep out errors as possible. Added a
    breakout for analog pin A1 to the bottom header.
    [Tracksoar v2 .brd, Tracksoar v2 .sch]
2017-06-07 Added Schematic PDFs
    Added schematic PDFs
2018-03-08 Moved BME280
    moved the bme 280 sensor away from the 3v regulator to help mitigate thermal issues.
    [Tracksoar v2 .brd]
2018-03-08 Removed Pours
    removed pours from under the lm3480 to limit heat reaching the bme280
    [Tracksoar v2 .brd]
2018-03-08 added thermal pads
    added thermal pads and vias below the lm3480 to prevent biasing the temp sensor
    [Tracksoar v2 .brd]
2018-03-10 updated thermal pads
    updated thermal pads
    [Tracksoar v2 .brd]
2018-03-18 removed ldo and level shifter
    replaced the 3v ldo with a switching regulator, replaced level shifter with resistor dividers.
    [Tracksoar v2 .brd, Tracksoar v2 .sch, Tracksoar v2 shield template.brd, Tracksoar v2 shield template.sch]
2018-03-18 added pdfs
    added pdfs of schematic and board layout
2018-03-23 updated rf paths
    seperated RF GND from GND and coupled via an inductor. Implemented path cleanups. Made all RF impedence matched.
    [Tracksoar v2 .brd, Tracksoar v2 .sch]
2018-03-23 moved gpio header
    moved the gpioheader to better center it
    [Tracksoar v2 .brd]
2018-04-21 added buck regulator
    swapped the linear regulator for a buck converter.
    [Tracksoar v2 .brd, Tracksoar v2 .sch]
2018-04-21 fixed 3v reg
    the 3v reg wiring was corrected and output cap moved closer to the regulator.
    [Tracksoar v2 .brd, Tracksoar v2 .sch]
2018-04-21 Added gps backup cap
    added gps backup capacitor. Corrected serial voltage divider resistor values. Removed ground vias below gps module.
    [Tracksoar v2 .brd, Tracksoar v2 .sch]
2018-04-21 minor trace cleanup
    moved a few traces around for aesthetics.
    [Tracksoar v2 .brd]
2018-04-21 moved gnd via
    ground via for the backup cap was interferring with the GPS pads.
    [Tracksoar v2 .brd]
2018-04-21 added gnd vias
    added ground vias to shorten ground paths for the ltc3426, backup battery
    [Tracksoar v2 .brd]
2018-04-22 added a library
    added the ava library
    [Tracksoar v2 .brd]
2018-04-28 updated shield template
    updated shield template to be a breakout board for all IO into .1" headers
    [Tracksoar v2 shield template.brd, Tracksoar v2 shield template.sch]
2018-04-28 fixed short on serial RX of tracksoar v2
    fixed a short on the serial rx line that shorted it to ground due to a via. Updated silkscreen on the breakout board and named headers
    [Tracksoar v2 .brd, Tracksoar v2 shield template.brd, Tracksoar v2 shield template.sch]
2018-04-28 Updated breakout silkscreen
    cleaned up the breakout silkscreen
    [Tracksoar v2 .brd, Tracksoar v2 shield template.brd]
2018-04-28 fixed the v2 shield template
    renamed the breakout board and re-added the template.
    [Tracksoar v2 breakout.brd, Tracksoar v2 breakout.sch, Tracksoar v2 shield template.brd, Tracksoar v2 shield template.sch]
2018-05-04 Fixed airwire issue
    Fixed an issue with the v2 board that resulted from upgrading eagle to v9. It caused lots of very short airwires.
    [Tracksoar v2 .brd, Tracksoar v2 .sch]
2018-05-06 silkscreen updates
    minor silkscreen fixes
    [Tracksoar v2 .brd]
2018-05-06 updated breakout board silkscreen
    SCK pins was mis-labelled as SS
    [Tracksoar v2 breakout.brd]
2018-05-27 Schematic cleanup
    first pass at making the schematic more readable. Moved components to be more in line with the board layout.
    [Tracksoar v2 .brd, Tracksoar v2 .sch]
2018-05-28 added breakout mount holes
    added 2.8mm mounting holes with mouse bites for easy removal.
    [Tracksoar v2 .brd, Tracksoar v2 .sch]
2018-06-09 minor silkscreen cleanup
    moved GPIO pin names down to clear connector
    [Tracksoar v2 .brd]
2018-06-09 more silkscreen tweaks
    made header labels larger added a1 label
    [Tracksoar v2 .brd]
2018-06-09 moved a1 label
    moved a1 label
    [Tracksoar v2 .brd]
2018-06-17 added cutdown boards
    added cutdown test boards
    [cutdown.brd, cutdown.sch]
2018-06-17 updated board outline
    updated board outline to makek the bottom cutout complete.
    [cutdown.brd]
2018-06-17 silkscreen cleanup
    moved silkscreen tvalues and bvalues to tnames and bnames so they show up correctly in macrofab / oshpark.
    [Tracksoar v2 .brd]
2018-06-29 added active gps board
    added a v2 version with active gps antenna
    [Tracksoar v2 active gps.brd, Tracksoar v2 active gps.sch]
2018-07-14 Added boards
    Added boards for a cutdown circuit, spi flash storage and spi flash breakout board and a shield template.
    [Tracksoar v2 flash shield test.brd, Tracksoar v2 flash shield test.sch, Tracksoar v2 flash.brd, Tracksoar v2 flash.sch, cutdown.brd, cutdown.sch]
2018-08-05 Schematic cleanup
    placed decoupling caps where they are located on the board. Placed items in groups and did my best to place nets near their origins. Also generally group items where they are located on the board.
    [Tracksoar v2 .brd, Tracksoar v2 .sch]
2019-05-08 Updated U$7
    updated u$7 on brd and sch file to include value and part number
    [Tracksoar v2 .brd, Tracksoar v2 .sch, Tracksoar v2 sd shield.brd, Tracksoar v2 sd shield.sch]
